qrafty-ai/hardware_designs/README.md

# hardware_designs

Hardware designs open-sourced by [QraftyAI](https://qrafty-ai.com).
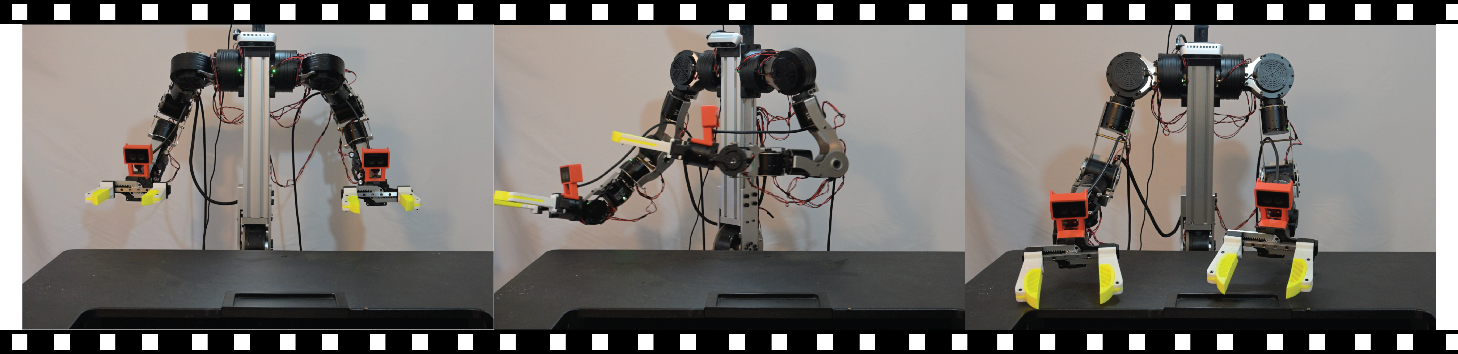
[picture p1: assets/fullarm.png]
Full Robot with Waist
  

Components:
+ `openarm_waist`: a waist extension for [OpenArm](https://openarm.dev/)
  
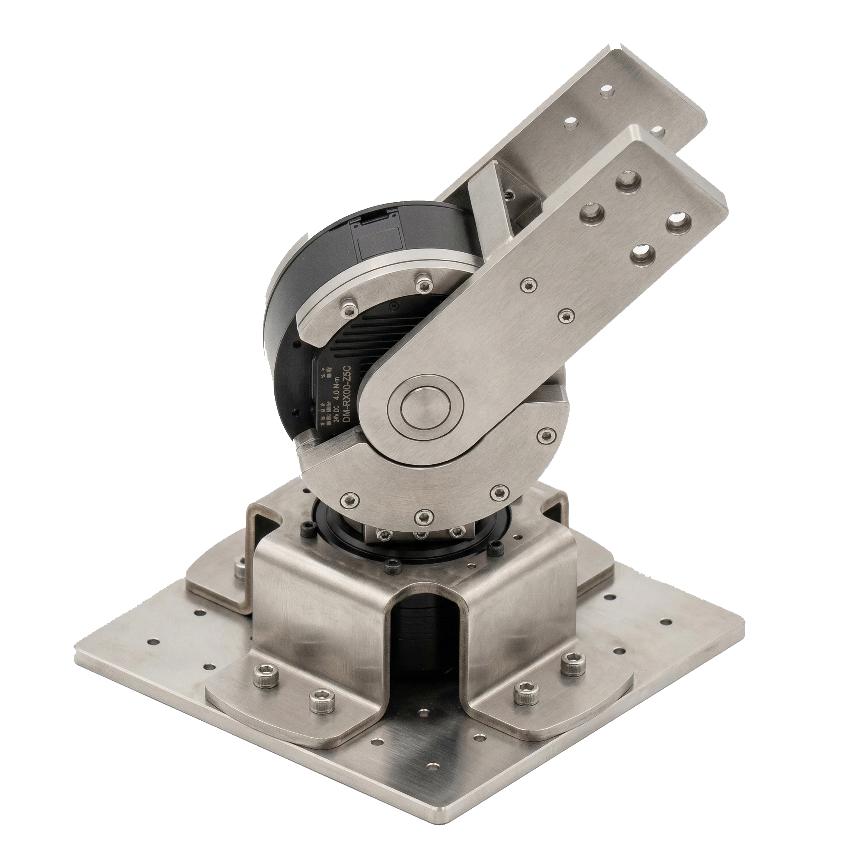
[picture p2: assets/waist_new.png]
Waist Assembly
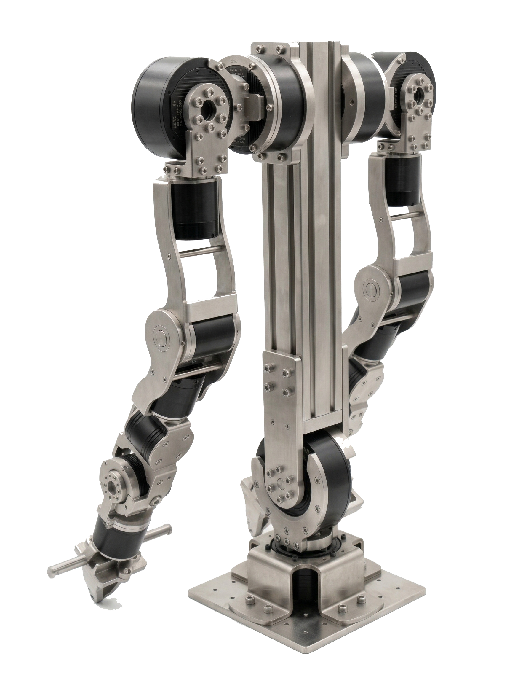
[picture p3: assets/fullrobot.png]
Full Robot with Waist
|  |  |
|:---:|:---:|
| Waist Assembly | Full Robot with Waist |
+ `teaarm_description`: full xacro/urdf description file for openarm with the custom waist
