qrafty-ai/hardware_designs/(list of files, cad)

Other CAD files:
openarm_waist/steps/assemble_urdf - J_waist_yaw_C.step
openarm_waist/steps/assemble_urdf - J_waist_pitch_C_CNC.step
openarm_waist/steps/assemble_urdf - J_waist_pitch_AB_CNC.step
openarm_waist/steps/assemble_urdf - J_waist_yaw_B_3D.step
openarm_waist/steps/assemble_urdf - J_waist_yaw_A_CNC.step
openarm_waist/steps/assemble_urdf - fl6804ZZ.step
openarm_waist/steps/assemble_urdf - square_base_plate.step
openarm_waist/steps/assemble_urdf - J_waist_yaw_A_CNC_A.step
openarm_waist/steps/assemble_urdf - J_waist_pitch_D_for_CNC.step
openarm_waist/steps/assemble_urdf - J_waist_yaw_A_CNC_B.step
openarm_waist/steps/assemble_urdf - base_sheet_metal.step
teaarm_description/meshes/collision/right_arm_l6_3.stl
teaarm_description/meshes/visual/torso_link.stl
teaarm_description/meshes/collision/right_arm_l4_7.stl
teaarm_description/meshes/visual/left_arm_l3.stl
teaarm_description/meshes/collision/right_arm_l1_4.stl
teaarm_description/meshes/visual/left_arm_l2.stl
teaarm_description/meshes/collision/waist_link_2.stl
teaarm_description/meshes/visual/right_arm_l6.stl
teaarm_description/meshes/collision/left_arm_l1_7.stl
teaarm_description/meshes/visual/right_arm_l1.stl
teaarm_description/meshes/collision/left_arm_l7_1.stl
teaarm_description/meshes/visual/right_arm_l7.stl
teaarm_description/meshes/collision/left_arm_l6_7.stl
teaarm_description/meshes/visual/right_arm_l2.stl
teaarm_description/meshes/collision/left_arm_l3_6.stl
teaarm_description/meshes/visual/right_arm_l5.stl
teaarm_description/meshes/collision/left_arm_l1_1.stl
teaarm_description/meshes/visual/left_arm_l5.stl
openarm_waist/steps/openarm_waist.step
teaarm_description/meshes/collision/right_arm_l1_6.stl
teaarm_description/meshes/visual/left_arm_l6.stl
teaarm_description/meshes/collision/right_arm_l5_7.stl
teaarm_description/meshes/visual/left_arm_l1.stl
teaarm_description/meshes/collision/right_arm_l6_5.stl
teaarm_description/meshes/visual/left_arm_l4.stl
teaarm_description/meshes/collision/left_arm_l3_3.stl
teaarm_description/meshes/visual/left_arm_l7.stl
teaarm_description/meshes/collision/left_arm_l6_6.stl
teaarm_description/meshes/visual/waist_link.stl
teaarm_description/meshes/collision/right_arm_l2_5.stl
teaarm_description/meshes/visual/base_link.stl
teaarm_description/meshes/collision/left_arm_l7_3.stl
teaarm_description/meshes/visual/right_arm_l3.stl
teaarm_description/meshes/collision/right_arm_l2_6.stl
teaarm_description/meshes/visual/right_arm_l4.stl
teaarm_description/meshes/collision/right_arm_l2_7.stl
teaarm_description/meshes/collision/base_link_4.stl
teaarm_description/meshes/collision/right_arm_l5_5.stl
teaarm_description/meshes/collision/left_arm_l4_7.stl
teaarm_description/meshes/collision/right_arm_l3_5.stl
teaarm_description/meshes/collision/right_arm_l2_4.stl
teaarm_description/meshes/collision/left_arm_l2_6.stl
teaarm_description/meshes/collision/right_arm_l1_3.stl
teaarm_description/meshes/collision/right_arm_l7_6.stl
teaarm_description/meshes/collision/left_arm_l3_1.stl
teaarm_description/meshes/collision/left_arm_l4_3.stl
teaarm_description/meshes/collision/left_arm_l3_4.stl
teaarm_description/meshes/collision/left_arm_l1_2.stl
teaarm_description/meshes/collision/right_arm_l1_0.stl
teaarm_description/meshes/collision/base_link_0.stl
teaarm_description/meshes/collision/waist_link_1.stl
teaarm_description/meshes/collision/right_arm_l5_0.stl
teaarm_description/meshes/collision/left_arm_l6_5.stl
teaarm_description/meshes/collision/left_arm_l5_2.stl
teaarm_description/meshes/collision/right_arm_l4_3.stl
teaarm_description/meshes/collision/right_arm_l3_3.stl
teaarm_description/meshes/collision/right_arm_l7_0.stl
teaarm_description/meshes/collision/right_arm_l2_2.stl
teaarm_description/meshes/collision/right_arm_l3_7.stl
teaarm_description/meshes/collision/left_arm_l6_2.stl
teaarm_description/meshes/collision/left_arm_l2_2.stl
teaarm_description/meshes/collision/left_arm_l7_2.stl
teaarm_description/meshes/collision/left_arm_l7_6.stl
teaarm_description/meshes/collision/left_arm_l4_4.stl
teaarm_description/meshes/collision/left_arm_l5_6.stl
teaarm_description/meshes/collision/right_arm_l7_2.stl
teaarm_description/meshes/collision/right_arm_l6_6.stl
teaarm_description/meshes/collision/left_arm_l4_0.stl
teaarm_description/meshes/collision/left_arm_l3_7.stl
teaarm_description/meshes/collision/right_arm_l1_2.stl
teaarm_description/meshes/collision/waist_link_6.stl
teaarm_description/meshes/collision/right_arm_l3_2.stl
teaarm_description/meshes/collision/left_arm_l5_7.stl
teaarm_description/meshes/collision/right_arm_l4_4.stl
teaarm_description/meshes/collision/right_arm_l4_0.stl
teaarm_description/meshes/collision/right_arm_l3_1.stl
teaarm_description/meshes/collision/left_arm_l4_6.stl
teaarm_description/meshes/collision/torso_link_3.stl
teaarm_description/meshes/collision/right_arm_l6_0.stl
teaarm_description/meshes/collision/left_arm_l3_5.stl
teaarm_description/meshes/collision/left_arm_l1_3.stl
teaarm_description/meshes/collision/left_arm_l3_2.stl
teaarm_description/meshes/collision/left_arm_l5_0.stl
teaarm_description/meshes/collision/right_arm_l6_7.stl
teaarm_description/meshes/collision/left_arm_l2_0.stl
teaarm_description/meshes/collision/left_arm_l6_1.stl
teaarm_description/meshes/collision/torso_link_4.stl
teaarm_description/meshes/collision/right_arm_l4_1.stl
teaarm_description/meshes/collision/base_link_6.stl
teaarm_description/meshes/collision/base_link_5.stl
teaarm_description/meshes/collision/right_arm_l3_4.stl
teaarm_description/meshes/collision/right_arm_l2_0.stl
teaarm_description/meshes/collision/right_arm_l2_1.stl
teaarm_description/meshes/collision/left_arm_l4_2.stl
teaarm_description/meshes/collision/right_arm_l7_3.stl
teaarm_description/meshes/collision/left_arm_l4_5.stl
teaarm_description/meshes/collision/left_arm_l2_5.stl
teaarm_description/meshes/collision/right_arm_l6_2.stl
teaarm_description/meshes/collision/right_arm_l7_7.stl
teaarm_description/meshes/collision/right_arm_l5_3.stl
teaarm_description/meshes/collision/left_arm_l7_7.stl
teaarm_description/meshes/collision/left_arm_l1_0.stl
teaarm_description/meshes/collision/right_arm_l6_4.stl
teaarm_description/meshes/collision/right_arm_l1_1.stl
teaarm_description/meshes/collision/waist_link_4.stl
teaarm_description/meshes/collision/left_arm_l2_3.stl
teaarm_description/meshes/collision/left_arm_l5_1.stl
teaarm_description/meshes/collision/right_arm_l4_5.stl
teaarm_description/meshes/collision/left_arm_l4_1.stl
teaarm_description/meshes/collision/right_arm_l7_4.stl
teaarm_description/meshes/collision/left_arm_l2_4.stl
teaarm_description/meshes/collision/left_arm_l2_1.stl
teaarm_description/meshes/collision/left_arm_l2_7.stl
teaarm_description/meshes/collision/left_arm_l3_0.stl
teaarm_description/meshes/collision/left_arm_l1_4.stl
teaarm_description/meshes/collision/right_arm_l5_4.stl
teaarm_description/meshes/collision/right_arm_l6_1.stl
teaarm_description/meshes/collision/waist_link_3.stl
teaarm_description/meshes/collision/left_arm_l7_0.stl
teaarm_description/meshes/collision/left_arm_l5_4.stl
teaarm_description/meshes/collision/left_arm_l7_5.stl
teaarm_description/meshes/collision/left_arm_l6_4.stl
teaarm_description/meshes/collision/right_arm_l1_7.stl
teaarm_description/meshes/collision/left_arm_l5_3.stl
teaarm_description/meshes/collision/right_arm_l4_2.stl
teaarm_description/meshes/collision/torso_link_5.stl
teaarm_description/meshes/collision/right_arm_l3_0.stl
teaarm_description/meshes/collision/left_arm_l6_0.stl
teaarm_description/meshes/collision/base_link_7.stl
teaarm_description/meshes/collision/waist_link_0.stl
teaarm_description/meshes/collision/right_arm_l7_1.stl
teaarm_description/meshes/collision/right_arm_l7_5.stl
teaarm_description/meshes/collision/right_arm_l4_6.stl
teaarm_description/meshes/collision/base_link_2.stl
teaarm_description/meshes/collision/right_arm_l1_5.stl
teaarm_description/meshes/collision/left_arm_l1_6.stl
teaarm_description/meshes/collision/left_arm_l7_4.stl
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
