qrafty-ai/hardware_designs/teaarm_description/inertia_debug.md

# Inertia and Mesh Calculation Debug Report

**Total Robot Weight:** 17.1417 kg

## Link: base_link

| Part | BOM Match | Mass Source | Material | Volume (cm³) | Mass (kg) | Mesh Match | Status |
|---|---|---|---|---|---|---|---|
| assemble_urdf_1_sub-asm-base_1_square_base_plate | (fuzzy: square_base_plate) | BOM Mass | Aluminum - 6061 | 313.38 | 0.8524 | FOUND | ⚠️ Fuzzy matched to BOM entry 'square_base_plate' |
| assemble_urdf_1_sub-asm-base_1_base_sheet_metal | (fuzzy: base_sheet_metal) | BOM Mass | Stainless Steel 304 | 149.89 | 1.2036 | FOUND | ⚠️ Fuzzy matched to BOM entry 'base_sheet_metal' |
| assemble_urdf_1_sub-asm-base_1_Hex_socket_head_cap_screw_M6x100_x_12 | (fuzzy: Hex socket head cap screw M6x1.00 x 12) | BOM Mass | Stainless Steel | 0.74 | 0.0057 | FOUND | ⚠️ Fuzzy matched to BOM entry 'Hex socket head cap screw M6x1.00 x 12' |
| assemble_urdf_1_sub-asm-base_1_Hex_socket_head_cap_screw_M6x100_x_12 | (fuzzy: Hex socket head cap screw M6x1.00 x 12) | BOM Mass | Stainless Steel | 0.74 | 0.0057 | FOUND | ⚠️ Fuzzy matched to BOM entry 'Hex socket head cap screw M6x1.00 x 12' |
| assemble_urdf_1_sub-asm-base_1_Hex_socket_head_cap_screw_M6x100_x_12 | (fuzzy: Hex socket head cap screw M6x1.00 x 12) | BOM Mass | Stainless Steel | 0.74 | 0.0057 | FOUND | ⚠️ Fuzzy matched to BOM entry 'Hex socket head cap screw M6x1.00 x 12' |
| assemble_urdf_1_sub-asm-base_1_Hex_socket_head_cap_screw_M6x100_x_12 | (fuzzy: Hex socket head cap screw M6x1.00 x 12) | BOM Mass | Stainless Steel | 0.74 | 0.0057 | FOUND | ⚠️ Fuzzy matched to BOM entry 'Hex socket head cap screw M6x1.00 x 12' |
| assemble_urdf_1_sub-asm-base_1_Hex_socket_head_cap_screw_M6x100_x_12 | (fuzzy: Hex socket head cap screw M6x1.00 x 12) | BOM Mass | Stainless Steel | 0.74 | 0.0057 | FOUND | ⚠️ Fuzzy matched to BOM entry 'Hex socket head cap screw M6x1.00 x 12' |
| assemble_urdf_1_sub-asm-base_1_Hex_socket_head_cap_screw_M6x100_x_12 | (fuzzy: Hex socket head cap screw M6x1.00 x 12) | BOM Mass | Stainless Steel | 0.74 | 0.0057 | FOUND | ⚠️ Fuzzy matched to BOM entry 'Hex socket head cap screw M6x1.00 x 12' |
| assemble_urdf_1_sub-asm-base_1_Hex_socket_head_cap_screw_M6x100_x_12 | (fuzzy: Hex socket head cap screw M6x1.00 x 12) | BOM Mass | Stainless Steel | 0.74 | 0.0057 | FOUND | ⚠️ Fuzzy matched to BOM entry 'Hex socket head cap screw M6x1.00 x 12' |
| assemble_urdf_1_sub-asm-base_1_Hex_socket_head_cap_screw_M6x100_x_12 | (fuzzy: Hex socket head cap screw M6x1.00 x 12) | BOM Mass | Stainless Steel | 0.74 | 0.0057 | FOUND | ⚠️ Fuzzy matched to BOM entry 'Hex socket head cap screw M6x1.00 x 12' |
| assemble_urdf_1_sub-asm-base_1_8009P | (fuzzy: 8009P) | BOM Mass | - | 387.45 | 0.9210 | FOUND | ⚠️ Fuzzy matched to BOM entry '8009P' |
| assemble_urdf_1_sub-asm-base_1_Hex_socket_head_cap_screw_M4x070_x_10 | (fuzzy: Hex socket head cap screw M4x0.70 x 10) | BOM Mass | Stainless Steel | 0.26 | 0.0020 | FOUND | ⚠️ Fuzzy matched to BOM entry 'Hex socket head cap screw M4x0.70 x 10' |
| assemble_urdf_1_sub-asm-base_1_Hex_socket_head_cap_screw_M4x070_x_10 | (fuzzy: Hex socket head cap screw M4x0.70 x 10) | BOM Mass | Stainless Steel | 0.26 | 0.0020 | FOUND | ⚠️ Fuzzy matched to BOM entry 'Hex socket head cap screw M4x0.70 x 10' |
| assemble_urdf_1_sub-asm-base_1_Hex_socket_head_cap_screw_M4x070_x_10 | (fuzzy: Hex socket head cap screw M4x0.70 x 10) | BOM Mass | Stainless Steel | 0.26 | 0.0020 | FOUND | ⚠️ Fuzzy matched to BOM entry 'Hex socket head cap screw M4x0.70 x 10' |
| assemble_urdf_1_sub-asm-base_1_Hex_socket_head_cap_screw_M4x070_x_10 | (fuzzy: Hex socket head cap screw M4x0.70 x 10) | BOM Mass | Stainless Steel | 0.26 | 0.0020 | FOUND | ⚠️ Fuzzy matched to BOM entry 'Hex socket head cap screw M4x0.70 x 10' |
| assemble_urdf_1_sub-asm-base_1_Hex_socket_head_cap_screw_M4x070_x_10 | (fuzzy: Hex socket head cap screw M4x0.70 x 10) | BOM Mass | Stainless Steel | 0.26 | 0.0020 | FOUND | ⚠️ Fuzzy matched to BOM entry 'Hex socket head cap screw M4x0.70 x 10' |
| assemble_urdf_1_sub-asm-base_1_Hex_socket_head_cap_screw_M4x070_x_10 | (fuzzy: Hex socket head cap screw M4x0.70 x 10) | BOM Mass | Stainless Steel | 0.26 | 0.0020 | FOUND | ⚠️ Fuzzy matched to BOM entry 'Hex socket head cap screw M4x0.70 x 10' |

**Link Total:** 3.0349 kg
**Warnings:** 17 parts with issues

---

## Link: left_arm_l1

| Part | BOM Match | Mass Source | Material | Volume (cm³) | Mass (kg) | Mesh Match | Status |
|---|---|---|---|---|---|---|---|
| left_arm_1_l1_ASM_2_J1_C | (fuzzy: J1_C) | BOM Mass | Aluminum - 6061 | 23.08 | 0.0628 | FOUND | ⚠️ Fuzzy matched to BOM entry 'J1_C' |
| left_arm_1_l1_ASM_2_J1_D | (fuzzy: J1_D) | BOM Mass | Stainless Steel 304 | 3.51 | 0.0282 | FOUND | ⚠️ Fuzzy matched to BOM entry 'J1_D' |
| left_arm_1_l1_ASM_2_J1_E | (fuzzy: J1_E) | BOM Mass | Stainless Steel 304 | 3.86 | 0.0310 | FOUND | ⚠️ Fuzzy matched to BOM entry 'J1_E' |
| left_arm_1_l1_ASM_2_Hex_socket_head_cap_screw_M5x080_x_10 | (fuzzy: Hex socket head cap screw M5x0.80 x 10) | BOM Mass | Stainless Steel | 0.44 | 0.0034 | FOUND | ⚠️ Fuzzy matched to BOM entry 'Hex socket head cap screw M5x0.80 x 10' |
| left_arm_1_l1_ASM_2_Hex_socket_head_cap_screw_M5x080_x_10 | (fuzzy: Hex socket head cap screw M5x0.80 x 10) | BOM Mass | Stainless Steel | 0.44 | 0.0034 | FOUND | ⚠️ Fuzzy matched to BOM entry 'Hex socket head cap screw M5x0.80 x 10' |
| left_arm_1_l1_ASM_2_Hex_socket_head_cap_screw_M5x080_x_10 | (fuzzy: Hex socket head cap screw M5x0.80 x 10) | BOM Mass | Stainless Steel | 0.44 | 0.0034 | FOUND | ⚠️ Fuzzy matched to BOM entry 'Hex socket head cap screw M5x0.80 x 10' |
| left_arm_1_l1_ASM_2_Hex_socket_head_cap_screw_M5x080_x_10 | (fuzzy: Hex socket head cap screw M5x0.80 x 10) | BOM Mass | Stainless Steel | 0.44 | 0.0034 | FOUND | ⚠️ Fuzzy matched to BOM entry 'Hex socket head cap screw M5x0.80 x 10' |
| left_arm_1_l1_ASM_2_Hex_socket_head_cap_screw_M5x080_x_10 | (fuzzy: Hex socket head cap screw M5x0.80 x 10) | BOM Mass | Stainless Steel | 0.44 | 0.0034 | FOUND | ⚠️ Fuzzy matched to BOM entry 'Hex socket head cap screw M5x0.80 x 10' |
| left_arm_1_l1_ASM_2_Hex_socket_head_cap_screw_M4x070_x_10 | (fuzzy: Hex socket head cap screw M4x0.70 x 10) | BOM Mass | Stainless Steel | 0.26 | 0.0020 | FOUND | ⚠️ Fuzzy matched to BOM entry 'Hex socket head cap screw M4x0.70 x 10' |
| left_arm_1_l1_ASM_2_Hex_socket_head_cap_screw_M4x070_x_10 | (fuzzy: Hex socket head cap screw M4x0.70 x 10) | BOM Mass | Stainless Steel | 0.26 | 0.0020 | FOUND | ⚠️ Fuzzy matched to BOM entry 'Hex socket head cap screw M4x0.70 x 10' |
| left_arm_1_l1_ASM_2_Hex_socket_head_cap_screw_M4x070_x_8 | (fuzzy: Hex socket head cap screw M4x0.70 x 8) | BOM Mass | Stainless Steel | 0.24 | 0.0018 | FOUND | ⚠️ Fuzzy matched to BOM entry 'Hex socket head cap screw M4x0.70 x 8' |
| left_arm_1_l1_ASM_2_Hex_socket_head_cap_screw_M4x070_x_8 | (fuzzy: Hex socket head cap screw M4x0.70 x 8) | BOM Mass | Stainless Steel | 0.24 | 0.0018 | FOUND | ⚠️ Fuzzy matched to BOM entry 'Hex socket head cap screw M4x0.70 x 8' |
| left_arm_1_l1_ASM_2_Hex_socket_head_cap_screw_M4x070_x_8 | (fuzzy: Hex socket head cap screw M4x0.70 x 8) | BOM Mass | Stainless Steel | 0.24 | 0.0018 | FOUND | ⚠️ Fuzzy matched to BOM entry 'Hex socket head cap screw M4x0.70 x 8' |
| left_arm_1_l1_ASM_2_DM-J8009P-2EC | (fuzzy: DM-J8009P-2EC) | BOM Mass | - | 387.45 | 0.9210 | FOUND | ⚠️ Fuzzy matched to BOM entry 'DM-J8009P-2EC' |
| left_arm_1_l1_ASM_2_Hex_socket_head_cap_screw_M4x070_x_10 | (fuzzy: Hex socket head cap screw M4x0.70 x 10) | BOM Mass | Stainless Steel | 0.26 | 0.0020 | FOUND | ⚠️ Fuzzy matched to BOM entry 'Hex socket head cap screw M4x0.70 x 10' |
| left_arm_1_l1_ASM_2_Hex_socket_head_cap_screw_M4x070_x_10 | (fuzzy: Hex socket head cap screw M4x0.70 x 10) | BOM Mass | Stainless Steel | 0.26 | 0.0020 | FOUND | ⚠️ Fuzzy matched to BOM entry 'Hex socket head cap screw M4x0.70 x 10' |
| left_arm_1_l1_ASM_2_Hex_socket_head_cap_screw_M4x070_x_10 | (fuzzy: Hex socket head cap screw M4x0.70 x 10) | BOM Mass | Stainless Steel | 0.26 | 0.0020 | FOUND | ⚠️ Fuzzy matched to BOM entry 'Hex socket head cap screw M4x0.70 x 10' |
| left_arm_1_l1_ASM_2_Hex_socket_head_cap_screw_M4x070_x_8 | (fuzzy: Hex socket head cap screw M4x0.70 x 8) | BOM Mass | Stainless Steel | 0.24 | 0.0018 | FOUND | ⚠️ Fuzzy matched to BOM entry 'Hex socket head cap screw M4x0.70 x 8' |

**Link Total:** 1.0775 kg
**Warnings:** 18 parts with issues

---

## Link: left_arm_l2

| Part | BOM Match | Mass Source | Material | Volume (cm³) | Mass (kg) | Mesh Match | Status |
|---|---|---|---|---|---|---|---|
| left_arm_1_l2_ASM_2_J2_A | (fuzzy: J2_A) | BOM Mass | Stainless Steel 304 | 14.18 | 0.1138 | FOUND | ⚠️ Fuzzy matched to BOM entry 'J2_A' |
| left_arm_1_l2_ASM_2_J2_C | (fuzzy: J2_C) | BOM Mass | Stainless Steel 304 | 4.05 | 0.0325 | FOUND | ⚠️ Fuzzy matched to BOM entry 'J2_C' |
| left_arm_1_l2_ASM_2_Hex_socket_head_cap_screw_M4x070_x_10 | (fuzzy: Hex socket head cap screw M4x0.70 x 10) | BOM Mass | Stainless Steel | 0.26 | 0.0020 | FOUND | ⚠️ Fuzzy matched to BOM entry 'Hex socket head cap screw M4x0.70 x 10' |
| left_arm_1_l2_ASM_2_Hex_socket_head_cap_screw_M5x080_x_10 | (fuzzy: Hex socket head cap screw M5x0.80 x 10) | BOM Mass | Stainless Steel | 0.44 | 0.0034 | FOUND | ⚠️ Fuzzy matched to BOM entry 'Hex socket head cap screw M5x0.80 x 10' |
| left_arm_1_l2_ASM_2_Hex_socket_head_cap_screw_M5x080_x_10 | (fuzzy: Hex socket head cap screw M5x0.80 x 10) | BOM Mass | Stainless Steel | 0.44 | 0.0034 | FOUND | ⚠️ Fuzzy matched to BOM entry 'Hex socket head cap screw M5x0.80 x 10' |
| left_arm_1_l2_ASM_2_Hex_socket_head_cap_screw_M5x080_x_10 | (fuzzy: Hex socket head cap screw M5x0.80 x 10) | BOM Mass | Stainless Steel | 0.44 | 0.0034 | FOUND | ⚠️ Fuzzy matched to BOM entry 'Hex socket head cap screw M5x0.80 x 10' |
| left_arm_1_l2_ASM_2_Hex_socket_head_cap_screw_M5x080_x_10 | (fuzzy: Hex socket head cap screw M5x0.80 x 10) | BOM Mass | Stainless Steel | 0.44 | 0.0034 | FOUND | ⚠️ Fuzzy matched to BOM entry 'Hex socket head cap screw M5x0.80 x 10' |
| left_arm_1_l2_ASM_2_Hex_socket_head_cap_screw_M5x080_x_10 | (fuzzy: Hex socket head cap screw M5x0.80 x 10) | BOM Mass | Stainless Steel | 0.44 | 0.0034 | FOUND | ⚠️ Fuzzy matched to BOM entry 'Hex socket head cap screw M5x0.80 x 10' |
| left_arm_1_l2_ASM_2_Hex_socket_head_cap_screw_M5x080_x_10 | (fuzzy: Hex socket head cap screw M5x0.80 x 10) | BOM Mass | Stainless Steel | 0.44 | 0.0034 | FOUND | ⚠️ Fuzzy matched to BOM entry 'Hex socket head cap screw M5x0.80 x 10' |
| left_arm_1_l2_ASM_2_Hex_socket_head_cap_screw_M3x050_x_8 | (fuzzy: Hex socket head cap screw M3x0.50 x 8) | BOM Mass | Stainless Steel | 0.12 | 0.0009 | FOUND | ⚠️ Fuzzy matched to BOM entry 'Hex socket head cap screw M3x0.50 x 8' |
| left_arm_1_l2_ASM_2_J2_B | (fuzzy: J2_B) | BOM Mass | Aluminum - 6061 | 22.81 | 0.0620 | FOUND | ⚠️ Fuzzy matched to BOM entry 'J2_B' |
| left_arm_1_l2_ASM_2_Hex_socket_head_cap_screw_M4x070_x_6 | (fuzzy: Hex socket head cap screw M4x0.70 x 6) | BOM Mass | Stainless Steel | 0.21 | 0.0016 | FOUND | ⚠️ Fuzzy matched to BOM entry 'Hex socket head cap screw M4x0.70 x 6' |
| left_arm_1_l2_ASM_2_Hex_socket_head_cap_screw_M4x070_x_6 | (fuzzy: Hex socket head cap screw M4x0.70 x 6) | BOM Mass | Stainless Steel | 0.21 | 0.0016 | FOUND | ⚠️ Fuzzy matched to BOM entry 'Hex socket head cap screw M4x0.70 x 6' |
| left_arm_1_l2_ASM_2_Hex_socket_head_cap_screw_M4x070_x_6 | (fuzzy: Hex socket head cap screw M4x0.70 x 6) | BOM Mass | Stainless Steel | 0.21 | 0.0016 | FOUND | ⚠️ Fuzzy matched to BOM entry 'Hex socket head cap screw M4x0.70 x 6' |
| left_arm_1_l2_ASM_2_Hex_socket_head_cap_screw_M4x070_x_6 | (fuzzy: Hex socket head cap screw M4x0.70 x 6) | BOM Mass | Stainless Steel | 0.21 | 0.0016 | FOUND | ⚠️ Fuzzy matched to BOM entry 'Hex socket head cap screw M4x0.70 x 6' |
| left_arm_1_l2_ASM_2_Hex_socket_head_cap_screw_M4x070_x_6 | (fuzzy: Hex socket head cap screw M4x0.70 x 6) | BOM Mass | Stainless Steel | 0.21 | 0.0016 | FOUND | ⚠️ Fuzzy matched to BOM entry 'Hex socket head cap screw M4x0.70 x 6' |
| left_arm_1_l2_ASM_2_Hex_socket_head_cap_screw_M4x070_x_6 | (fuzzy: Hex socket head cap screw M4x0.70 x 6) | BOM Mass | Stainless Steel | 0.21 | 0.0016 | FOUND | ⚠️ Fuzzy matched to BOM entry 'Hex socket head cap screw M4x0.70 x 6' |
| left_arm_1_l2_ASM_2_Hex_socket_head_cap_screw_M4x070_x_6 | (fuzzy: Hex socket head cap screw M4x0.70 x 6) | BOM Mass | Stainless Steel | 0.21 | 0.0016 | FOUND | ⚠️ Fuzzy matched to BOM entry 'Hex socket head cap screw M4x0.70 x 6' |
| left_arm_1_l2_ASM_2_Hex_socket_head_cap_screw_M4x070_x_6 | (fuzzy: Hex socket head cap screw M4x0.70 x 6) | BOM Mass | Stainless Steel | 0.21 | 0.0016 | FOUND | ⚠️ Fuzzy matched to BOM entry 'Hex socket head cap screw M4x0.70 x 6' |
| left_arm_1_l2_ASM_2_Hex_socket_head_cap_screw_M3x050_x_14 | (fuzzy: Hex socket head cap screw M3x0.50 x 14) | BOM Mass | Stainless Steel | 0.16 | 0.0013 | FOUND | ⚠️ Fuzzy matched to BOM entry 'Hex socket head cap screw M3x0.50 x 14' |
| left_arm_1_l2_ASM_2_Hex_socket_head_cap_screw_M3x050_x_14 | (fuzzy: Hex socket head cap screw M3x0.50 x 14) | BOM Mass | Stainless Steel | 0.16 | 0.0013 | FOUND | ⚠️ Fuzzy matched to BOM entry 'Hex socket head cap screw M3x0.50 x 14' |
| left_arm_1_l2_ASM_2_Hex_socket_head_cap_screw_M3x050_x_14 | (fuzzy: Hex socket head cap screw M3x0.50 x 14) | BOM Mass | Stainless Steel | 0.16 | 0.0013 | FOUND | ⚠️ Fuzzy matched to BOM entry 'Hex socket head cap screw M3x0.50 x 14' |
| left_arm_1_l2_ASM_2_Hex_socket_head_cap_screw_M3x050_x_14 | (fuzzy: Hex socket head cap screw M3x0.50 x 14) | BOM Mass | Stainless Steel | 0.16 | 0.0013 | FOUND | ⚠️ Fuzzy matched to BOM entry 'Hex socket head cap screw M3x0.50 x 14' |
| left_arm_1_l2_ASM_2_Hex_socket_head_cap_screw_M3x050_x_14 | (fuzzy: Hex socket head cap screw M3x0.50 x 14) | BOM Mass | Stainless Steel | 0.16 | 0.0013 | FOUND | ⚠️ Fuzzy matched to BOM entry 'Hex socket head cap screw M3x0.50 x 14' |
| left_arm_1_l2_ASM_2_Hex_socket_head_cap_screw_M3x050_x_14 | (fuzzy: Hex socket head cap screw M3x0.50 x 14) | BOM Mass | Stainless Steel | 0.16 | 0.0013 | FOUND | ⚠️ Fuzzy matched to BOM entry 'Hex socket head cap screw M3x0.50 x 14' |

**Link Total:** 0.2526 kg
**Warnings:** 25 parts with issues

---

## Link: left_arm_l3

| Part | BOM Match | Mass Source | Material | Volume (cm³) | Mass (kg) | Mesh Match | Status |
|---|---|---|---|---|---|---|---|
| left_arm_1_l3_ASM_2_4340P | (fuzzy: 4340P) | BOM Mass | - | 135.71 | 0.3750 | FOUND | ⚠️ Fuzzy matched to BOM entry '4340P' |
| left_arm_1_l3_ASM_2_J4_A | (fuzzy: J4_A) | BOM Mass | Stainless Steel 304 | 23.37 | 0.1877 | FOUND | ⚠️ Fuzzy matched to BOM entry 'J4_A' |
| left_arm_1_l3_ASM_2_4340 | (fuzzy: 4340) | BOM Mass | - | 128.48 | 0.3620 | FOUND | ⚠️ Fuzzy matched to BOM entry '4340' |
| left_arm_1_l3_ASM_2_Hex_socket_head_cap_screw_M3x050_x_6 | (fuzzy: Hex socket head cap screw M3x0.50 x 6) | BOM Mass | Stainless Steel | 0.11 | 0.0008 | FOUND | ⚠️ Fuzzy matched to BOM entry 'Hex socket head cap screw M3x0.50 x 6' |
| left_arm_1_l3_ASM_2_Hex_socket_head_cap_screw_M3x050_x_6 | (fuzzy: Hex socket head cap screw M3x0.50 x 6) | BOM Mass | Stainless Steel | 0.11 | 0.0008 | FOUND | ⚠️ Fuzzy matched to BOM entry 'Hex socket head cap screw M3x0.50 x 6' |
| left_arm_1_l3_ASM_2_Hex_socket_head_cap_screw_M3x050_x_6 | (fuzzy: Hex socket head cap screw M3x0.50 x 6) | BOM Mass | Stainless Steel | 0.11 | 0.0008 | FOUND | ⚠️ Fuzzy matched to BOM entry 'Hex socket head cap screw M3x0.50 x 6' |
| left_arm_1_l3_ASM_2_Hex_socket_head_cap_screw_M3x050_x_6 | (fuzzy: Hex socket head cap screw M3x0.50 x 6) | BOM Mass | Stainless Steel | 0.11 | 0.0008 | FOUND | ⚠️ Fuzzy matched to BOM entry 'Hex socket head cap screw M3x0.50 x 6' |
| left_arm_1_l3_ASM_2_Hex_socket_head_cap_screw_M3x050_x_6 | (fuzzy: Hex socket head cap screw M3x0.50 x 6) | BOM Mass | Stainless Steel | 0.11 | 0.0008 | FOUND | ⚠️ Fuzzy matched to BOM entry 'Hex socket head cap screw M3x0.50 x 6' |
| left_arm_1_l3_ASM_2_Hex_socket_head_cap_screw_M3x050_x_6 | (fuzzy: Hex socket head cap screw M3x0.50 x 6) | BOM Mass | Stainless Steel | 0.11 | 0.0008 | FOUND | ⚠️ Fuzzy matched to BOM entry 'Hex socket head cap screw M3x0.50 x 6' |
| left_arm_1_l3_ASM_2_Hex_socket_head_cap_screw_M3x050_x_6 | (fuzzy: Hex socket head cap screw M3x0.50 x 6) | BOM Mass | Stainless Steel | 0.11 | 0.0008 | FOUND | ⚠️ Fuzzy matched to BOM entry 'Hex socket head cap screw M3x0.50 x 6' |
| left_arm_1_l3_ASM_2_Hex_socket_head_cap_screw_M3x050_x_6 | (fuzzy: Hex socket head cap screw M3x0.50 x 6) | BOM Mass | Stainless Steel | 0.11 | 0.0008 | FOUND | ⚠️ Fuzzy matched to BOM entry 'Hex socket head cap screw M3x0.50 x 6' |
| left_arm_1_l3_ASM_2_Hex_socket_head_cap_screw_M3x050_x_6 | (fuzzy: Hex socket head cap screw M3x0.50 x 6) | BOM Mass | Stainless Steel | 0.11 | 0.0008 | FOUND | ⚠️ Fuzzy matched to BOM entry 'Hex socket head cap screw M3x0.50 x 6' |
| left_arm_1_l3_ASM_2_Hex_socket_head_cap_screw_M3x050_x_6 | (fuzzy: Hex socket head cap screw M3x0.50 x 6) | BOM Mass | Stainless Steel | 0.11 | 0.0008 | FOUND | ⚠️ Fuzzy matched to BOM entry 'Hex socket head cap screw M3x0.50 x 6' |
| left_arm_1_l3_ASM_2_Hex_socket_head_cap_screw_M3x050_x_6 | (fuzzy: Hex socket head cap screw M3x0.50 x 6) | BOM Mass | Stainless Steel | 0.11 | 0.0008 | FOUND | ⚠️ Fuzzy matched to BOM entry 'Hex socket head cap screw M3x0.50 x 6' |
| left_arm_1_l3_ASM_2_Hex_socket_head_cap_screw_M3x050_x_6 | (fuzzy: Hex socket head cap screw M3x0.50 x 6) | BOM Mass | Stainless Steel | 0.11 | 0.0008 | FOUND | ⚠️ Fuzzy matched to BOM entry 'Hex socket head cap screw M3x0.50 x 6' |
| left_arm_1_l3_ASM_2_Hex_socket_head_cap_screw_M3x050_x_6 | (fuzzy: Hex socket head cap screw M3x0.50 x 6) | BOM Mass | Stainless Steel | 0.11 | 0.0008 | FOUND | ⚠️ Fuzzy matched to BOM entry 'Hex socket head cap screw M3x0.50 x 6' |
| left_arm_1_l3_ASM_2_Hex_socket_head_cap_screw_M3x050_x_6 | (fuzzy: Hex socket head cap screw M3x0.50 x 6) | BOM Mass | Stainless Steel | 0.11 | 0.0008 | FOUND | ⚠️ Fuzzy matched to BOM entry 'Hex socket head cap screw M3x0.50 x 6' |
| left_arm_1_l3_ASM_2_Hex_socket_head_cap_screw_M3x050_x_6 | (fuzzy: Hex socket head cap screw M3x0.50 x 6) | BOM Mass | Stainless Steel | 0.11 | 0.0008 | FOUND | ⚠️ Fuzzy matched to BOM entry 'Hex socket head cap screw M3x0.50 x 6' |
| left_arm_1_l3_ASM_2_Hex_socket_head_cap_screw_M3x050_x_6 | (fuzzy: Hex socket head cap screw M3x0.50 x 6) | BOM Mass | Stainless Steel | 0.11 | 0.0008 | FOUND | ⚠️ Fuzzy matched to BOM entry 'Hex socket head cap screw M3x0.50 x 6' |
| left_arm_1_l3_ASM_2_Hex_socket_head_cap_screw_M3x050_x_6 | (fuzzy: Hex socket head cap screw M3x0.50 x 6) | BOM Mass | Stainless Steel | 0.11 | 0.0008 | FOUND | ⚠️ Fuzzy matched to BOM entry 'Hex socket head cap screw M3x0.50 x 6' |
| left_arm_1_l3_ASM_2_Hex_socket_head_cap_screw_M3x050_x_6 | (fuzzy: Hex socket head cap screw M3x0.50 x 6) | BOM Mass | Stainless Steel | 0.11 | 0.0008 | FOUND | ⚠️ Fuzzy matched to BOM entry 'Hex socket head cap screw M3x0.50 x 6' |
| left_arm_1_l3_ASM_2_copper_pillar_61 | (fuzzy: copper pillar 61) | BOM Mass | Copper | 1.30 | 0.0116 | FOUND | ⚠️ Fuzzy matched to BOM entry 'copper pillar 61' |
| left_arm_1_l3_ASM_2_Hex_socket_head_cap_screw_M3x050_x_8 | (fuzzy: Hex socket head cap screw M3x0.50 x 8) | BOM Mass | Stainless Steel | 0.12 | 0.0009 | FOUND | ⚠️ Fuzzy matched to BOM entry 'Hex socket head cap screw M3x0.50 x 8' |
| left_arm_1_l3_ASM_2_Hex_socket_head_cap_screw_M3x050_x_8 | (fuzzy: Hex socket head cap screw M3x0.50 x 8) | BOM Mass | Stainless Steel | 0.12 | 0.0009 | FOUND | ⚠️ Fuzzy matched to BOM entry 'Hex socket head cap screw M3x0.50 x 8' |
| left_arm_1_l3_ASM_2_J4_B | (fuzzy: J4_B) | BOM Mass | ppa-cf | 25.43 | 0.0318 | FOUND | ⚠️ Fuzzy matched to BOM entry 'J4_B' |
| left_arm_1_l3_ASM_2_C-FL6803ZZ | (fuzzy: C-FL6803ZZ) | BOM Mass | - | 1.54 | 0.0000 | FOUND | ⚠️ Fuzzy matched to BOM entry 'C-FL6803ZZ' |
| left_arm_1_l3_ASM_2_Hex_socket_head_cap_screw_M3x050_x_6 | (fuzzy: Hex socket head cap screw M3x0.50 x 6) | BOM Mass | Stainless Steel | 0.11 | 0.0008 | FOUND | ⚠️ Fuzzy matched to BOM entry 'Hex socket head cap screw M3x0.50 x 6' |
| left_arm_1_l3_ASM_2_Hex_socket_head_cap_screw_M3x050_x_6 | (fuzzy: Hex socket head cap screw M3x0.50 x 6) | BOM Mass | Stainless Steel | 0.11 | 0.0008 | FOUND | ⚠️ Fuzzy matched to BOM entry 'Hex socket head cap screw M3x0.50 x 6' |
| left_arm_1_l3_ASM_2_Hex_socket_head_cap_screw_M3x050_x_6 | (fuzzy: Hex socket head cap screw M3x0.50 x 6) | BOM Mass | Stainless Steel | 0.11 | 0.0008 | FOUND | ⚠️ Fuzzy matched to BOM entry 'Hex socket head cap screw M3x0.50 x 6' |
| left_arm_1_l3_ASM_2_Hex_socket_head_cap_screw_M3x050_x_6 | (fuzzy: Hex socket head cap screw M3x0.50 x 6) | BOM Mass | Stainless Steel | 0.11 | 0.0008 | FOUND | ⚠️ Fuzzy matched to BOM entry 'Hex socket head cap screw M3x0.50 x 6' |

**Link Total:** 0.9880 kg
**Warnings:** 30 parts with issues

---

## Link: left_arm_l4

| Part | BOM Match | Mass Source | Material | Volume (cm³) | Mass (kg) | Mesh Match | Status |
|---|---|---|---|---|---|---|---|
| left_arm_1_l4_ASM_2_J4_C | (fuzzy: J4_C) | BOM Mass | Aluminum - 6061 | 4.54 | 0.0123 | FOUND | ⚠️ Fuzzy matched to BOM entry 'J4_C' |
| left_arm_1_l4_ASM_2_J4_E | (fuzzy: J4_E) | BOM Mass | Stainless Steel 304 | 9.95 | 0.0799 | FOUND | ⚠️ Fuzzy matched to BOM entry 'J4_E' |
| left_arm_1_l4_ASM_2_Hex_socket_head_cap_screw_M3x050_x_6 | (fuzzy: Hex socket head cap screw M3x0.50 x 6) | BOM Mass | Stainless Steel | 0.11 | 0.0008 | FOUND | ⚠️ Fuzzy matched to BOM entry 'Hex socket head cap screw M3x0.50 x 6' |
| left_arm_1_l4_ASM_2_Hex_socket_head_cap_screw_M3x050_x_6 | (fuzzy: Hex socket head cap screw M3x0.50 x 6) | BOM Mass | Stainless Steel | 0.11 | 0.0008 | FOUND | ⚠️ Fuzzy matched to BOM entry 'Hex socket head cap screw M3x0.50 x 6' |
| left_arm_1_l4_ASM_2_Hex_socket_head_cap_screw_M3x050_x_6 | (fuzzy: Hex socket head cap screw M3x0.50 x 6) | BOM Mass | Stainless Steel | 0.11 | 0.0008 | FOUND | ⚠️ Fuzzy matched to BOM entry 'Hex socket head cap screw M3x0.50 x 6' |
| left_arm_1_l4_ASM_2_Hex_socket_head_cap_screw_M3x050_x_6 | (fuzzy: Hex socket head cap screw M3x0.50 x 6) | BOM Mass | Stainless Steel | 0.11 | 0.0008 | FOUND | ⚠️ Fuzzy matched to BOM entry 'Hex socket head cap screw M3x0.50 x 6' |
| left_arm_1_l4_ASM_2_Hex_socket_head_cap_screw_M3x050_x_6 | (fuzzy: Hex socket head cap screw M3x0.50 x 6) | BOM Mass | Stainless Steel | 0.11 | 0.0008 | FOUND | ⚠️ Fuzzy matched to BOM entry 'Hex socket head cap screw M3x0.50 x 6' |
| left_arm_1_l4_ASM_2_Hex_socket_head_cap_screw_M3x050_x_6 | (fuzzy: Hex socket head cap screw M3x0.50 x 6) | BOM Mass | Stainless Steel | 0.11 | 0.0008 | FOUND | ⚠️ Fuzzy matched to BOM entry 'Hex socket head cap screw M3x0.50 x 6' |
| left_arm_1_l4_ASM_2_4310 | (fuzzy: 4310) | BOM Mass | - | 109.88 | 0.3000 | FOUND | ⚠️ Fuzzy matched to BOM entry '4310' |
| left_arm_1_l4_ASM_2_copper_pillar_742 | (fuzzy: copper pillar 74.2) | BOM Mass | Copper | 1.58 | 0.0141 | FOUND | ⚠️ Fuzzy matched to BOM entry 'copper pillar 74.2' |
| left_arm_1_l4_ASM_2_copper_pillar_742 | (fuzzy: copper pillar 74.2) | BOM Mass | Copper | 1.58 | 0.0141 | FOUND | ⚠️ Fuzzy matched to BOM entry 'copper pillar 74.2' |
| left_arm_1_l4_ASM_2_Hex_socket_head_cap_screw_M3x050_x_8 | (fuzzy: Hex socket head cap screw M3x0.50 x 8) | BOM Mass | Stainless Steel | 0.12 | 0.0009 | FOUND | ⚠️ Fuzzy matched to BOM entry 'Hex socket head cap screw M3x0.50 x 8' |
| left_arm_1_l4_ASM_2_Hex_socket_head_cap_screw_M3x050_x_8 | (fuzzy: Hex socket head cap screw M3x0.50 x 8) | BOM Mass | Stainless Steel | 0.12 | 0.0009 | FOUND | ⚠️ Fuzzy matched to BOM entry 'Hex socket head cap screw M3x0.50 x 8' |
| left_arm_1_l4_ASM_2_Hex_socket_head_cap_screw_M3x050_x_6 | (fuzzy: Hex socket head cap screw M3x0.50 x 6) | BOM Mass | Stainless Steel | 0.11 | 0.0008 | FOUND | ⚠️ Fuzzy matched to BOM entry 'Hex socket head cap screw M3x0.50 x 6' |
| left_arm_1_l4_ASM_2_Hex_socket_head_cap_screw_M3x050_x_6 | (fuzzy: Hex socket head cap screw M3x0.50 x 6) | BOM Mass | Stainless Steel | 0.11 | 0.0008 | FOUND | ⚠️ Fuzzy matched to BOM entry 'Hex socket head cap screw M3x0.50 x 6' |
| left_arm_1_l4_ASM_2_Hex_socket_head_cap_screw_M3x050_x_6 | (fuzzy: Hex socket head cap screw M3x0.50 x 6) | BOM Mass | Stainless Steel | 0.11 | 0.0008 | FOUND | ⚠️ Fuzzy matched to BOM entry 'Hex socket head cap screw M3x0.50 x 6' |
| left_arm_1_l4_ASM_2_Hex_socket_head_cap_screw_M3x050_x_6 | (fuzzy: Hex socket head cap screw M3x0.50 x 6) | BOM Mass | Stainless Steel | 0.11 | 0.0008 | FOUND | ⚠️ Fuzzy matched to BOM entry 'Hex socket head cap screw M3x0.50 x 6' |
| left_arm_1_l4_ASM_2_Hex_socket_head_cap_screw_M3x050_x_6 | (fuzzy: Hex socket head cap screw M3x0.50 x 6) | BOM Mass | Stainless Steel | 0.11 | 0.0008 | FOUND | ⚠️ Fuzzy matched to BOM entry 'Hex socket head cap screw M3x0.50 x 6' |
| left_arm_1_l4_ASM_2_Hex_socket_head_cap_screw_M3x050_x_6 | (fuzzy: Hex socket head cap screw M3x0.50 x 6) | BOM Mass | Stainless Steel | 0.11 | 0.0008 | FOUND | ⚠️ Fuzzy matched to BOM entry 'Hex socket head cap screw M3x0.50 x 6' |
| left_arm_1_l4_ASM_2_Hex_socket_head_cap_screw_M3x050_x_6 | (fuzzy: Hex socket head cap screw M3x0.50 x 6) | BOM Mass | Stainless Steel | 0.11 | 0.0008 | FOUND | ⚠️ Fuzzy matched to BOM entry 'Hex socket head cap screw M3x0.50 x 6' |
| left_arm_1_l4_ASM_2_Hex_socket_head_cap_screw_M3x050_x_6 | (fuzzy: Hex socket head cap screw M3x0.50 x 6) | BOM Mass | Stainless Steel | 0.11 | 0.0008 | FOUND | ⚠️ Fuzzy matched to BOM entry 'Hex socket head cap screw M3x0.50 x 6' |
| left_arm_1_l4_ASM_2_Hex_socket_head_cap_screw_M3x050_x_6 | (fuzzy: Hex socket head cap screw M3x0.50 x 6) | BOM Mass | Stainless Steel | 0.11 | 0.0008 | FOUND | ⚠️ Fuzzy matched to BOM entry 'Hex socket head cap screw M3x0.50 x 6' |
| left_arm_1_l4_ASM_2_J4_D | (fuzzy: J4_D) | BOM Mass | Stainless Steel 304 | 9.67 | 0.0777 | FOUND | ⚠️ Fuzzy matched to BOM entry 'J4_D' |
| left_arm_1_l4_ASM_2_Hex_socket_head_cap_screw_M3x050_x_8 | (fuzzy: Hex socket head cap screw M3x0.50 x 8) | BOM Mass | Stainless Steel | 0.12 | 0.0009 | FOUND | ⚠️ Fuzzy matched to BOM entry 'Hex socket head cap screw M3x0.50 x 8' |
| left_arm_1_l4_ASM_2_Hex_socket_head_cap_screw_M3x050_x_8 | (fuzzy: Hex socket head cap screw M3x0.50 x 8) | BOM Mass | Stainless Steel | 0.12 | 0.0009 | FOUND | ⚠️ Fuzzy matched to BOM entry 'Hex socket head cap screw M3x0.50 x 8' |
| left_arm_1_l4_ASM_2_Hex_socket_head_cap_screw_M3x050_x_6 | (fuzzy: Hex socket head cap screw M3x0.50 x 6) | BOM Mass | Stainless Steel | 0.11 | 0.0008 | FOUND | ⚠️ Fuzzy matched to BOM entry 'Hex socket head cap screw M3x0.50 x 6' |
| left_arm_1_l4_ASM_2_Hex_socket_head_cap_screw_M3x050_x_6 | (fuzzy: Hex socket head cap screw M3x0.50 x 6) | BOM Mass | Stainless Steel | 0.11 | 0.0008 | FOUND | ⚠️ Fuzzy matched to BOM entry 'Hex socket head cap screw M3x0.50 x 6' |
| left_arm_1_l4_ASM_2_Hex_socket_head_cap_screw_M3x050_x_6 | (fuzzy: Hex socket head cap screw M3x0.50 x 6) | BOM Mass | Stainless Steel | 0.11 | 0.0008 | FOUND | ⚠️ Fuzzy matched to BOM entry 'Hex socket head cap screw M3x0.50 x 6' |

**Link Total:** 0.5166 kg
**Warnings:** 28 parts with issues

---

## Link: left_arm_l5

| Part | BOM Match | Mass Source | Material | Volume (cm³) | Mass (kg) | Mesh Match | Status |
|---|---|---|---|---|---|---|---|
| left_arm_1_l5_left_ASM_1_J5_A | (fuzzy: J5_A) | BOM Mass | ppa-cf | 12.65 | 0.0158 | FOUND | ⚠️ Fuzzy matched to BOM entry 'J5_A' |
| left_arm_1_l5_left_ASM_1_J6_B | (fuzzy: J6_B) | BOM Mass | Stainless Steel 304 | 5.37 | 0.0431 | FOUND | ⚠️ Fuzzy matched to BOM entry 'J6_B' |
| left_arm_1_l5_left_ASM_1_J6_A | (fuzzy: J6_A) | BOM Mass | Stainless Steel 304 | 6.73 | 0.0540 | FOUND | ⚠️ Fuzzy matched to BOM entry 'J6_A' |
| left_arm_1_l5_left_ASM_1_Hex_socket_head_cap_screw_M3x050_x_18 | (fuzzy: Hex socket head cap screw M3x0.50 x 18) | BOM Mass | Stainless Steel | 0.19 | 0.0015 | FOUND | ⚠️ Fuzzy matched to BOM entry 'Hex socket head cap screw M3x0.50 x 18' |
| left_arm_1_l5_left_ASM_1_Hex_socket_head_cap_screw_M3x050_x_18 | (fuzzy: Hex socket head cap screw M3x0.50 x 18) | BOM Mass | Stainless Steel | 0.19 | 0.0015 | FOUND | ⚠️ Fuzzy matched to BOM entry 'Hex socket head cap screw M3x0.50 x 18' |
| left_arm_1_l5_left_ASM_1_Hex_socket_head_cap_screw_M3x050_x_18 | (fuzzy: Hex socket head cap screw M3x0.50 x 18) | BOM Mass | Stainless Steel | 0.19 | 0.0015 | FOUND | ⚠️ Fuzzy matched to BOM entry 'Hex socket head cap screw M3x0.50 x 18' |
| left_arm_1_l5_left_ASM_1_Hex_socket_head_cap_screw_M3x050_x_18 | (fuzzy: Hex socket head cap screw M3x0.50 x 18) | BOM Mass | Stainless Steel | 0.19 | 0.0015 | FOUND | ⚠️ Fuzzy matched to BOM entry 'Hex socket head cap screw M3x0.50 x 18' |
| left_arm_1_l5_left_ASM_1_Hex_socket_head_cap_screw_M3x050_x_18 | (fuzzy: Hex socket head cap screw M3x0.50 x 18) | BOM Mass | Stainless Steel | 0.19 | 0.0015 | FOUND | ⚠️ Fuzzy matched to BOM entry 'Hex socket head cap screw M3x0.50 x 18' |
| left_arm_1_l5_left_ASM_1_Hex_socket_head_cap_screw_M3x050_x_18 | (fuzzy: Hex socket head cap screw M3x0.50 x 18) | BOM Mass | Stainless Steel | 0.19 | 0.0015 | FOUND | ⚠️ Fuzzy matched to BOM entry 'Hex socket head cap screw M3x0.50 x 18' |
| left_arm_1_l5_left_ASM_1_J6_C_left | (fuzzy: J6_C_left) | BOM Mass | Stainless Steel 304 | 2.12 | 0.0170 | FOUND | ⚠️ Fuzzy matched to BOM entry 'J6_C_left' |
| left_arm_1_l5_left_ASM_1_Hex_socket_head_cap_screw_M3x050_x_8 | (fuzzy: Hex socket head cap screw M3x0.50 x 8) | BOM Mass | Stainless Steel | 0.12 | 0.0009 | FOUND | ⚠️ Fuzzy matched to BOM entry 'Hex socket head cap screw M3x0.50 x 8' |
| left_arm_1_l5_left_ASM_1_Hex_socket_head_cap_screw_M3x050_x_8 | (fuzzy: Hex socket head cap screw M3x0.50 x 8) | BOM Mass | Stainless Steel | 0.12 | 0.0009 | FOUND | ⚠️ Fuzzy matched to BOM entry 'Hex socket head cap screw M3x0.50 x 8' |
| left_arm_1_l5_left_ASM_1_Hex_socket_head_cap_screw_M3x050_x_8 | (fuzzy: Hex socket head cap screw M3x0.50 x 8) | BOM Mass | Stainless Steel | 0.12 | 0.0009 | FOUND | ⚠️ Fuzzy matched to BOM entry 'Hex socket head cap screw M3x0.50 x 8' |
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
| left_arm_1_l5_left_ASM_1_Hex_socket_head_cap_screw_M3x050_x_6 | (fuzzy: Hex socket head cap screw M3x0.50 x 6) | BOM Mass | Stainless Steel | 0.11 | 0.0008 | FOUND | ⚠️ Fuzzy matched to BOM entry 'Hex socket head cap screw M3x0.50 x 6' |
| left_arm_1_l5_left_ASM_1_Hex_socket_head_cap_screw_M3x050_x_6 | (fuzzy: Hex socket head cap screw M3x0.50 x 6) | BOM Mass | Stainless Steel | 0.11 | 0.0008 | FOUND | ⚠️ Fuzzy matched to BOM entry 'Hex socket head cap screw M3x0.50 x 6' |
| left_arm_1_l5_left_ASM_1_Hex_socket_head_cap_screw_M3x050_x_6 | (fuzzy: Hex socket head cap screw M3x0.50 x 6) | BOM Mass | Stainless Steel | 0.11 | 0.0008 | FOUND | ⚠️ Fuzzy matched to BOM entry 'Hex socket head cap screw M3x0.50 x 6' |
| left_arm_1_l5_left_ASM_1_Hex_socket_head_cap_screw_M3x050_x_6 | (fuzzy: Hex socket head cap screw M3x0.50 x 6) | BOM Mass | Stainless Steel | 0.11 | 0.0008 | FOUND | ⚠️ Fuzzy matched to BOM entry 'Hex socket head cap screw M3x0.50 x 6' |
| left_arm_1_l5_left_ASM_1_Hex_socket_head_cap_screw_M3x050_x_6 | (fuzzy: Hex socket head cap screw M3x0.50 x 6) | BOM Mass | Stainless Steel | 0.11 | 0.0008 | FOUND | ⚠️ Fuzzy matched to BOM entry 'Hex socket head cap screw M3x0.50 x 6' |

**Link Total:** 0.4821 kg
**Warnings:** 38 parts with issues

---

## Link: left_arm_l6

| Part | BOM Match | Mass Source | Material | Volume (cm³) | Mass (kg) | Mesh Match | Status |
|---|---|---|---|---|---|---|---|
| left_arm_1_l6_URDF_1_J7_AB | (fuzzy: J7_AB) | BOM Mass | PETG | 29.36 | 0.0382 | FOUND | ⚠️ Fuzzy matched to BOM entry 'J7_AB' |
| left_arm_1_l6_URDF_1_4310 | (fuzzy: 4310) | BOM Mass | - | 109.88 | 0.3000 | FOUND | ⚠️ Fuzzy matched to BOM entry '4310' |
| left_arm_1_l6_URDF_1_Hex_socket_head_cap_screw_M3x050_x_8 | (fuzzy: Hex socket head cap screw M3x0.50 x 8) | BOM Mass | Stainless Steel | 0.12 | 0.0009 | FOUND | ⚠️ Fuzzy matched to BOM entry 'Hex socket head cap screw M3x0.50 x 8' |
| left_arm_1_l6_URDF_1_Hex_socket_head_cap_screw_M3x050_x_8 | (fuzzy: Hex socket head cap screw M3x0.50 x 8) | BOM Mass | Stainless Steel | 0.12 | 0.0009 | FOUND | ⚠️ Fuzzy matched to BOM entry 'Hex socket head cap screw M3x0.50 x 8' |
| left_arm_1_l6_URDF_1_Hex_socket_head_cap_screw_M3x050_x_8 | (fuzzy: Hex socket head cap screw M3x0.50 x 8) | BOM Mass | Stainless Steel | 0.12 | 0.0009 | FOUND | ⚠️ Fuzzy matched to BOM entry 'Hex socket head cap screw M3x0.50 x 8' |
| left_arm_1_l6_URDF_1_J7_C | (fuzzy: J7_C) | BOM Mass | Aluminum - 6061 | 3.20 | 0.0087 | FOUND | ⚠️ Fuzzy matched to BOM entry 'J7_C' |
| left_arm_1_l6_URDF_1_Hex_socket_head_cap_screw_M3x050_x_8 | (fuzzy: Hex socket head cap screw M3x0.50 x 8) | BOM Mass | Stainless Steel | 0.12 | 0.0009 | FOUND | ⚠️ Fuzzy matched to BOM entry 'Hex socket head cap screw M3x0.50 x 8' |
| left_arm_1_l6_URDF_1_Hex_socket_head_cap_screw_M3x050_x_8 | (fuzzy: Hex socket head cap screw M3x0.50 x 8) | BOM Mass | Stainless Steel | 0.12 | 0.0009 | FOUND | ⚠️ Fuzzy matched to BOM entry 'Hex socket head cap screw M3x0.50 x 8' |

**Link Total:** 0.3515 kg
**Warnings:** 8 parts with issues

---

## Link: left_arm_l7

| Part | BOM Match | Mass Source | Material | Volume (cm³) | Mass (kg) | Mesh Match | Status |
|---|---|---|---|---|---|---|---|
| left_arm_1_J8_A | (fuzzy: J8_A) | BOM Mass | Aluminum - 6061 | 13.49 | 0.0367 | FOUND | ⚠️ Fuzzy matched to BOM entry 'J8_A' |
| left_arm_1_gripper_1_J8_B | (fuzzy: J8_B) | BOM Mass | ppa-cf | 19.97 | 0.0218 | FOUND | ⚠️ Fuzzy matched to BOM entry 'J8_B' |
| left_arm_1_gripper_1_4310 | (fuzzy: 4310) | BOM Mass | - | 109.88 | 0.3000 | FOUND | ⚠️ Fuzzy matched to BOM entry '4310' |
| left_arm_1_gripper_1_J8_B | (fuzzy: J8_B) | BOM Mass | ppa-cf | 19.97 | 0.0218 | FOUND | ⚠️ Fuzzy matched to BOM entry 'J8_B' |
| left_arm_1_gripper_1_rail_connector | - | Default Density | - | 8.46 | 0.0085 | FOUND | ⚠️ Not found in BOM |
| left_arm_1_gripper_1_swivel_rotor | - | Default Density | - | 11.95 | 0.0120 | FOUND | ⚠️ Not found in BOM |
| left_arm_1_gripper_1_J8_A | (fuzzy: J8_A) | BOM Mass | Aluminum - 6061 | 13.49 | 0.0367 | FOUND | ⚠️ Fuzzy matched to BOM entry 'J8_A' |
| left_arm_1_gripper_1_rse2b10-155_rail_v3 | - | Default Density | - | 6.22 | 0.0062 | FOUND | ⚠️ Not found in BOM |
| left_arm_1_gripper_1_swivel_link | - | Default Density | - | 1.39 | 0.0014 | FOUND | ⚠️ Not found in BOM |
| left_arm_1_gripper_1_swivel_link | - | Default Density | - | 1.39 | 0.0014 | FOUND | ⚠️ Not found in BOM |
| left_arm_1_gripper_1_rse2b10-155_block_v3 | - | Default Density | - | 3.52 | 0.0035 | FOUND | ⚠️ Not found in BOM |
| left_arm_1_gripper_1_rse2b10-155_block_v3 | - | Default Density | - | 3.52 | 0.0035 | FOUND | ⚠️ Not found in BOM |
| left_arm_1_gripper_1_rail_CNC_attachment | - | Default Density | - | 6.25 | 0.0063 | FOUND | ⚠️ Not found in BOM |
| left_arm_1_gripper_1_rail_CNC_attachment | - | Default Density | - | 6.25 | 0.0063 | FOUND | ⚠️ Not found in BOM |
| left_arm_1_gripper_1_left_jaw | - | Default Density | - | 27.86 | 0.0279 | FOUND | ⚠️ Not found in BOM |
| left_arm_1_gripper_1_right_jaw | - | Default Density | - | 27.86 | 0.0279 | FOUND | ⚠️ Not found in BOM |

**Link Total:** 0.5217 kg
**Warnings:** 16 parts with issues

---

## Link: right_arm_l1

| Part | BOM Match | Mass Source | Material | Volume (cm³) | Mass (kg) | Mesh Match | Status |
|---|---|---|---|---|---|---|---|
| right_arm_1_l1_ASM_2_J1_C | (fuzzy: J1_C) | BOM Mass | Aluminum - 6061 | 23.08 | 0.0628 | FOUND | ⚠️ Fuzzy matched to BOM entry 'J1_C' |
| right_arm_1_l1_ASM_2_J1_D | (fuzzy: J1_D) | BOM Mass | Stainless Steel 304 | 3.51 | 0.0282 | FOUND | ⚠️ Fuzzy matched to BOM entry 'J1_D' |
| right_arm_1_l1_ASM_2_J1_E | (fuzzy: J1_E) | BOM Mass | Stainless Steel 304 | 3.86 | 0.0310 | FOUND | ⚠️ Fuzzy matched to BOM entry 'J1_E' |
| right_arm_1_l1_ASM_2_Hex_socket_head_cap_screw_M5x080_x_10 | (fuzzy: Hex socket head cap screw M5x0.80 x 10) | BOM Mass | Stainless Steel | 0.44 | 0.0034 | FOUND | ⚠️ Fuzzy matched to BOM entry 'Hex socket head cap screw M5x0.80 x 10' |
| right_arm_1_l1_ASM_2_Hex_socket_head_cap_screw_M5x080_x_10 | (fuzzy: Hex socket head cap screw M5x0.80 x 10) | BOM Mass | Stainless Steel | 0.44 | 0.0034 | FOUND | ⚠️ Fuzzy matched to BOM entry 'Hex socket head cap screw M5x0.80 x 10' |
| right_arm_1_l1_ASM_2_Hex_socket_head_cap_screw_M5x080_x_10 | (fuzzy: Hex socket head cap screw M5x0.80 x 10) | BOM Mass | Stainless Steel | 0.44 | 0.0034 | FOUND | ⚠️ Fuzzy matched to BOM entry 'Hex socket head cap screw M5x0.80 x 10' |
| right_arm_1_l1_ASM_2_Hex_socket_head_cap_screw_M5x080_x_10 | (fuzzy: Hex socket head cap screw M5x0.80 x 10) | BOM Mass | Stainless Steel | 0.44 | 0.0034 | FOUND | ⚠️ Fuzzy matched to BOM entry 'Hex socket head cap screw M5x0.80 x 10' |
| right_arm_1_l1_ASM_2_Hex_socket_head_cap_screw_M5x080_x_10 | (fuzzy: Hex socket head cap screw M5x0.80 x 10) | BOM Mass | Stainless Steel | 0.44 | 0.0034 | FOUND | ⚠️ Fuzzy matched to BOM entry 'Hex socket head cap screw M5x0.80 x 10' |
| right_arm_1_l1_ASM_2_Hex_socket_head_cap_screw_M4x070_x_10 | (fuzzy: Hex socket head cap screw M4x0.70 x 10) | BOM Mass | Stainless Steel | 0.26 | 0.0020 | FOUND | ⚠️ Fuzzy matched to BOM entry 'Hex socket head cap screw M4x0.70 x 10' |
| right_arm_1_l1_ASM_2_Hex_socket_head_cap_screw_M4x070_x_10 | (fuzzy: Hex socket head cap screw M4x0.70 x 10) | BOM Mass | Stainless Steel | 0.26 | 0.0020 | FOUND | ⚠️ Fuzzy matched to BOM entry 'Hex socket head cap screw M4x0.70 x 10' |
| right_arm_1_l1_ASM_2_Hex_socket_head_cap_screw_M4x070_x_8 | (fuzzy: Hex socket head cap screw M4x0.70 x 8) | BOM Mass | Stainless Steel | 0.24 | 0.0018 | FOUND | ⚠️ Fuzzy matched to BOM entry 'Hex socket head cap screw M4x0.70 x 8' |
| right_arm_1_l1_ASM_2_Hex_socket_head_cap_screw_M4x070_x_8 | (fuzzy: Hex socket head cap screw M4x0.70 x 8) | BOM Mass | Stainless Steel | 0.24 | 0.0018 | FOUND | ⚠️ Fuzzy matched to BOM entry 'Hex socket head cap screw M4x0.70 x 8' |
| right_arm_1_l1_ASM_2_Hex_socket_head_cap_screw_M4x070_x_8 | (fuzzy: Hex socket head cap screw M4x0.70 x 8) | BOM Mass | Stainless Steel | 0.24 | 0.0018 | FOUND | ⚠️ Fuzzy matched to BOM entry 'Hex socket head cap screw M4x0.70 x 8' |
| right_arm_1_l1_ASM_2_DM-J8009P-2EC | (fuzzy: DM-J8009P-2EC) | BOM Mass | - | 387.45 | 0.9210 | FOUND | ⚠️ Fuzzy matched to BOM entry 'DM-J8009P-2EC' |
| right_arm_1_l1_ASM_2_Hex_socket_head_cap_screw_M4x070_x_10 | (fuzzy: Hex socket head cap screw M4x0.70 x 10) | BOM Mass | Stainless Steel | 0.26 | 0.0020 | FOUND | ⚠️ Fuzzy matched to BOM entry 'Hex socket head cap screw M4x0.70 x 10' |
| right_arm_1_l1_ASM_2_Hex_socket_head_cap_screw_M4x070_x_10 | (fuzzy: Hex socket head cap screw M4x0.70 x 10) | BOM Mass | Stainless Steel | 0.26 | 0.0020 | FOUND | ⚠️ Fuzzy matched to BOM entry 'Hex socket head cap screw M4x0.70 x 10' |
| right_arm_1_l1_ASM_2_Hex_socket_head_cap_screw_M4x070_x_10 | (fuzzy: Hex socket head cap screw M4x0.70 x 10) | BOM Mass | Stainless Steel | 0.26 | 0.0020 | FOUND | ⚠️ Fuzzy matched to BOM entry 'Hex socket head cap screw M4x0.70 x 10' |
| right_arm_1_l1_ASM_2_Hex_socket_head_cap_screw_M4x070_x_8 | (fuzzy: Hex socket head cap screw M4x0.70 x 8) | BOM Mass | Stainless Steel | 0.24 | 0.0018 | FOUND | ⚠️ Fuzzy matched to BOM entry 'Hex socket head cap screw M4x0.70 x 8' |

**Link Total:** 1.0775 kg
**Warnings:** 18 parts with issues

---

## Link: right_arm_l2

| Part | BOM Match | Mass Source | Material | Volume (cm³) | Mass (kg) | Mesh Match | Status |
|---|---|---|---|---|---|---|---|
| right_arm_1_l2_ASM_2_J2_A | (fuzzy: J2_A) | BOM Mass | Stainless Steel 304 | 14.18 | 0.1138 | FOUND | ⚠️ Fuzzy matched to BOM entry 'J2_A' |
| right_arm_1_l2_ASM_2_J2_C | (fuzzy: J2_C) | BOM Mass | Stainless Steel 304 | 4.05 | 0.0325 | FOUND | ⚠️ Fuzzy matched to BOM entry 'J2_C' |
| right_arm_1_l2_ASM_2_Hex_socket_head_cap_screw_M4x070_x_10 | (fuzzy: Hex socket head cap screw M4x0.70 x 10) | BOM Mass | Stainless Steel | 0.26 | 0.0020 | FOUND | ⚠️ Fuzzy matched to BOM entry 'Hex socket head cap screw M4x0.70 x 10' |
| right_arm_1_l2_ASM_2_Hex_socket_head_cap_screw_M5x080_x_10 | (fuzzy: Hex socket head cap screw M5x0.80 x 10) | BOM Mass | Stainless Steel | 0.44 | 0.0034 | FOUND | ⚠️ Fuzzy matched to BOM entry 'Hex socket head cap screw M5x0.80 x 10' |
| right_arm_1_l2_ASM_2_Hex_socket_head_cap_screw_M5x080_x_10 | (fuzzy: Hex socket head cap screw M5x0.80 x 10) | BOM Mass | Stainless Steel | 0.44 | 0.0034 | FOUND | ⚠️ Fuzzy matched to BOM entry 'Hex socket head cap screw M5x0.80 x 10' |
| right_arm_1_l2_ASM_2_Hex_socket_head_cap_screw_M5x080_x_10 | (fuzzy: Hex socket head cap screw M5x0.80 x 10) | BOM Mass | Stainless Steel | 0.44 | 0.0034 | FOUND | ⚠️ Fuzzy matched to BOM entry 'Hex socket head cap screw M5x0.80 x 10' |
| right_arm_1_l2_ASM_2_Hex_socket_head_cap_screw_M5x080_x_10 | (fuzzy: Hex socket head cap screw M5x0.80 x 10) | BOM Mass | Stainless Steel | 0.44 | 0.0034 | FOUND | ⚠️ Fuzzy matched to BOM entry 'Hex socket head cap screw M5x0.80 x 10' |
| right_arm_1_l2_ASM_2_Hex_socket_head_cap_screw_M5x080_x_10 | (fuzzy: Hex socket head cap screw M5x0.80 x 10) | BOM Mass | Stainless Steel | 0.44 | 0.0034 | FOUND | ⚠️ Fuzzy matched to BOM entry 'Hex socket head cap screw M5x0.80 x 10' |
| right_arm_1_l2_ASM_2_Hex_socket_head_cap_screw_M5x080_x_10 | (fuzzy: Hex socket head cap screw M5x0.80 x 10) | BOM Mass | Stainless Steel | 0.44 | 0.0034 | FOUND | ⚠️ Fuzzy matched to BOM entry 'Hex socket head cap screw M5x0.80 x 10' |
| right_arm_1_l2_ASM_2_Hex_socket_head_cap_screw_M3x050_x_8 | (fuzzy: Hex socket head cap screw M3x0.50 x 8) | BOM Mass | Stainless Steel | 0.12 | 0.0009 | FOUND | ⚠️ Fuzzy matched to BOM entry 'Hex socket head cap screw M3x0.50 x 8' |
| right_arm_1_l2_ASM_2_J2_B | (fuzzy: J2_B) | BOM Mass | Aluminum - 6061 | 22.81 | 0.0620 | FOUND | ⚠️ Fuzzy matched to BOM entry 'J2_B' |
| right_arm_1_l2_ASM_2_Hex_socket_head_cap_screw_M4x070_x_6 | (fuzzy: Hex socket head cap screw M4x0.70 x 6) | BOM Mass | Stainless Steel | 0.21 | 0.0016 | FOUND | ⚠️ Fuzzy matched to BOM entry 'Hex socket head cap screw M4x0.70 x 6' |
| right_arm_1_l2_ASM_2_Hex_socket_head_cap_screw_M4x070_x_6 | (fuzzy: Hex socket head cap screw M4x0.70 x 6) | BOM Mass | Stainless Steel | 0.21 | 0.0016 | FOUND | ⚠️ Fuzzy matched to BOM entry 'Hex socket head cap screw M4x0.70 x 6' |
| right_arm_1_l2_ASM_2_Hex_socket_head_cap_screw_M4x070_x_6 | (fuzzy: Hex socket head cap screw M4x0.70 x 6) | BOM Mass | Stainless Steel | 0.21 | 0.0016 | FOUND | ⚠️ Fuzzy matched to BOM entry 'Hex socket head cap screw M4x0.70 x 6' |
| right_arm_1_l2_ASM_2_Hex_socket_head_cap_screw_M4x070_x_6 | (fuzzy: Hex socket head cap screw M4x0.70 x 6) | BOM Mass | Stainless Steel | 0.21 | 0.0016 | FOUND | ⚠️ Fuzzy matched to BOM entry 'Hex socket head cap screw M4x0.70 x 6' |
| right_arm_1_l2_ASM_2_Hex_socket_head_cap_screw_M4x070_x_6 | (fuzzy: Hex socket head cap screw M4x0.70 x 6) | BOM Mass | Stainless Steel | 0.21 | 0.0016 | FOUND | ⚠️ Fuzzy matched to BOM entry 'Hex socket head cap screw M4x0.70 x 6' |
| right_arm_1_l2_ASM_2_Hex_socket_head_cap_screw_M4x070_x_6 | (fuzzy: Hex socket head cap screw M4x0.70 x 6) | BOM Mass | Stainless Steel | 0.21 | 0.0016 | FOUND | ⚠️ Fuzzy matched to BOM entry 'Hex socket head cap screw M4x0.70 x 6' |
| right_arm_1_l2_ASM_2_Hex_socket_head_cap_screw_M4x070_x_6 | (fuzzy: Hex socket head cap screw M4x0.70 x 6) | BOM Mass | Stainless Steel | 0.21 | 0.0016 | FOUND | ⚠️ Fuzzy matched to BOM entry 'Hex socket head cap screw M4x0.70 x 6' |
| right_arm_1_l2_ASM_2_Hex_socket_head_cap_screw_M4x070_x_6 | (fuzzy: Hex socket head cap screw M4x0.70 x 6) | BOM Mass | Stainless Steel | 0.21 | 0.0016 | FOUND | ⚠️ Fuzzy matched to BOM entry 'Hex socket head cap screw M4x0.70 x 6' |
| right_arm_1_l2_ASM_2_Hex_socket_head_cap_screw_M3x050_x_14 | (fuzzy: Hex socket head cap screw M3x0.50 x 14) | BOM Mass | Stainless Steel | 0.16 | 0.0013 | FOUND | ⚠️ Fuzzy matched to BOM entry 'Hex socket head cap screw M3x0.50 x 14' |
| right_arm_1_l2_ASM_2_Hex_socket_head_cap_screw_M3x050_x_14 | (fuzzy: Hex socket head cap screw M3x0.50 x 14) | BOM Mass | Stainless Steel | 0.16 | 0.0013 | FOUND | ⚠️ Fuzzy matched to BOM entry 'Hex socket head cap screw M3x0.50 x 14' |
| right_arm_1_l2_ASM_2_Hex_socket_head_cap_screw_M3x050_x_14 | (fuzzy: Hex socket head cap screw M3x0.50 x 14) | BOM Mass | Stainless Steel | 0.16 | 0.0013 | FOUND | ⚠️ Fuzzy matched to BOM entry 'Hex socket head cap screw M3x0.50 x 14' |
| right_arm_1_l2_ASM_2_Hex_socket_head_cap_screw_M3x050_x_14 | (fuzzy: Hex socket head cap screw M3x0.50 x 14) | BOM Mass | Stainless Steel | 0.16 | 0.0013 | FOUND | ⚠️ Fuzzy matched to BOM entry 'Hex socket head cap screw M3x0.50 x 14' |
| right_arm_1_l2_ASM_2_Hex_socket_head_cap_screw_M3x050_x_14 | (fuzzy: Hex socket head cap screw M3x0.50 x 14) | BOM Mass | Stainless Steel | 0.16 | 0.0013 | FOUND | ⚠️ Fuzzy matched to BOM entry 'Hex socket head cap screw M3x0.50 x 14' |
| right_arm_1_l2_ASM_2_Hex_socket_head_cap_screw_M3x050_x_14 | (fuzzy: Hex socket head cap screw M3x0.50 x 14) | BOM Mass | Stainless Steel | 0.16 | 0.0013 | FOUND | ⚠️ Fuzzy matched to BOM entry 'Hex socket head cap screw M3x0.50 x 14' |

**Link Total:** 0.2526 kg
**Warnings:** 25 parts with issues

---

## Link: right_arm_l3

| Part | BOM Match | Mass Source | Material | Volume (cm³) | Mass (kg) | Mesh Match | Status |
|---|---|---|---|---|---|---|---|
| right_arm_1_l3_ASM_2_4340P | (fuzzy: 4340P) | BOM Mass | - | 135.71 | 0.3750 | FOUND | ⚠️ Fuzzy matched to BOM entry '4340P' |
| right_arm_1_l3_ASM_2_J4_A | (fuzzy: J4_A) | BOM Mass | Stainless Steel 304 | 23.37 | 0.1877 | FOUND | ⚠️ Fuzzy matched to BOM entry 'J4_A' |
| right_arm_1_l3_ASM_2_4340 | (fuzzy: 4340) | BOM Mass | - | 128.48 | 0.3620 | FOUND | ⚠️ Fuzzy matched to BOM entry '4340' |
| right_arm_1_l3_ASM_2_Hex_socket_head_cap_screw_M3x050_x_6 | (fuzzy: Hex socket head cap screw M3x0.50 x 6) | BOM Mass | Stainless Steel | 0.11 | 0.0008 | FOUND | ⚠️ Fuzzy matched to BOM entry 'Hex socket head cap screw M3x0.50 x 6' |
| right_arm_1_l3_ASM_2_Hex_socket_head_cap_screw_M3x050_x_6 | (fuzzy: Hex socket head cap screw M3x0.50 x 6) | BOM Mass | Stainless Steel | 0.11 | 0.0008 | FOUND | ⚠️ Fuzzy matched to BOM entry 'Hex socket head cap screw M3x0.50 x 6' |
| right_arm_1_l3_ASM_2_Hex_socket_head_cap_screw_M3x050_x_6 | (fuzzy: Hex socket head cap screw M3x0.50 x 6) | BOM Mass | Stainless Steel | 0.11 | 0.0008 | FOUND | ⚠️ Fuzzy matched to BOM entry 'Hex socket head cap screw M3x0.50 x 6' |
| right_arm_1_l3_ASM_2_Hex_socket_head_cap_screw_M3x050_x_6 | (fuzzy: Hex socket head cap screw M3x0.50 x 6) | BOM Mass | Stainless Steel | 0.11 | 0.0008 | FOUND | ⚠️ Fuzzy matched to BOM entry 'Hex socket head cap screw M3x0.50 x 6' |
| right_arm_1_l3_ASM_2_Hex_socket_head_cap_screw_M3x050_x_6 | (fuzzy: Hex socket head cap screw M3x0.50 x 6) | BOM Mass | Stainless Steel | 0.11 | 0.0008 | FOUND | ⚠️ Fuzzy matched to BOM entry 'Hex socket head cap screw M3x0.50 x 6' |
| right_arm_1_l3_ASM_2_Hex_socket_head_cap_screw_M3x050_x_6 | (fuzzy: Hex socket head cap screw M3x0.50 x 6) | BOM Mass | Stainless Steel | 0.11 | 0.0008 | FOUND | ⚠️ Fuzzy matched to BOM entry 'Hex socket head cap screw M3x0.50 x 6' |
| right_arm_1_l3_ASM_2_Hex_socket_head_cap_screw_M3x050_x_6 | (fuzzy: Hex socket head cap screw M3x0.50 x 6) | BOM Mass | Stainless Steel | 0.11 | 0.0008 | FOUND | ⚠️ Fuzzy matched to BOM entry 'Hex socket head cap screw M3x0.50 x 6' |
| right_arm_1_l3_ASM_2_Hex_socket_head_cap_screw_M3x050_x_6 | (fuzzy: Hex socket head cap screw M3x0.50 x 6) | BOM Mass | Stainless Steel | 0.11 | 0.0008 | FOUND | ⚠️ Fuzzy matched to BOM entry 'Hex socket head cap screw M3x0.50 x 6' |
| right_arm_1_l3_ASM_2_Hex_socket_head_cap_screw_M3x050_x_6 | (fuzzy: Hex socket head cap screw M3x0.50 x 6) | BOM Mass | Stainless Steel | 0.11 | 0.0008 | FOUND | ⚠️ Fuzzy matched to BOM entry 'Hex socket head cap screw M3x0.50 x 6' |
| right_arm_1_l3_ASM_2_Hex_socket_head_cap_screw_M3x050_x_6 | (fuzzy: Hex socket head cap screw M3x0.50 x 6) | BOM Mass | Stainless Steel | 0.11 | 0.0008 | FOUND | ⚠️ Fuzzy matched to BOM entry 'Hex socket head cap screw M3x0.50 x 6' |
| right_arm_1_l3_ASM_2_Hex_socket_head_cap_screw_M3x050_x_6 | (fuzzy: Hex socket head cap screw M3x0.50 x 6) | BOM Mass | Stainless Steel | 0.11 | 0.0008 | FOUND | ⚠️ Fuzzy matched to BOM entry 'Hex socket head cap screw M3x0.50 x 6' |
| right_arm_1_l3_ASM_2_Hex_socket_head_cap_screw_M3x050_x_6 | (fuzzy: Hex socket head cap screw M3x0.50 x 6) | BOM Mass | Stainless Steel | 0.11 | 0.0008 | FOUND | ⚠️ Fuzzy matched to BOM entry 'Hex socket head cap screw M3x0.50 x 6' |
| right_arm_1_l3_ASM_2_Hex_socket_head_cap_screw_M3x050_x_6 | (fuzzy: Hex socket head cap screw M3x0.50 x 6) | BOM Mass | Stainless Steel | 0.11 | 0.0008 | FOUND | ⚠️ Fuzzy matched to BOM entry 'Hex socket head cap screw M3x0.50 x 6' |
| right_arm_1_l3_ASM_2_Hex_socket_head_cap_screw_M3x050_x_6 | (fuzzy: Hex socket head cap screw M3x0.50 x 6) | BOM Mass | Stainless Steel | 0.11 | 0.0008 | FOUND | ⚠️ Fuzzy matched to BOM entry 'Hex socket head cap screw M3x0.50 x 6' |
| right_arm_1_l3_ASM_2_Hex_socket_head_cap_screw_M3x050_x_6 | (fuzzy: Hex socket head cap screw M3x0.50 x 6) | BOM Mass | Stainless Steel | 0.11 | 0.0008 | FOUND | ⚠️ Fuzzy matched to BOM entry 'Hex socket head cap screw M3x0.50 x 6' |
| right_arm_1_l3_ASM_2_Hex_socket_head_cap_screw_M3x050_x_6 | (fuzzy: Hex socket head cap screw M3x0.50 x 6) | BOM Mass | Stainless Steel | 0.11 | 0.0008 | FOUND | ⚠️ Fuzzy matched to BOM entry 'Hex socket head cap screw M3x0.50 x 6' |
| right_arm_1_l3_ASM_2_Hex_socket_head_cap_screw_M3x050_x_6 | (fuzzy: Hex socket head cap screw M3x0.50 x 6) | BOM Mass | Stainless Steel | 0.11 | 0.0008 | FOUND | ⚠️ Fuzzy matched to BOM entry 'Hex socket head cap screw M3x0.50 x 6' |
| right_arm_1_l3_ASM_2_Hex_socket_head_cap_screw_M3x050_x_6 | (fuzzy: Hex socket head cap screw M3x0.50 x 6) | BOM Mass | Stainless Steel | 0.11 | 0.0008 | FOUND | ⚠️ Fuzzy matched to BOM entry 'Hex socket head cap screw M3x0.50 x 6' |
| right_arm_1_l3_ASM_2_copper_pillar_61 | (fuzzy: copper pillar 61) | BOM Mass | Copper | 1.30 | 0.0116 | FOUND | ⚠️ Fuzzy matched to BOM entry 'copper pillar 61' |
| right_arm_1_l3_ASM_2_Hex_socket_head_cap_screw_M3x050_x_8 | (fuzzy: Hex socket head cap screw M3x0.50 x 8) | BOM Mass | Stainless Steel | 0.12 | 0.0009 | FOUND | ⚠️ Fuzzy matched to BOM entry 'Hex socket head cap screw M3x0.50 x 8' |
| right_arm_1_l3_ASM_2_Hex_socket_head_cap_screw_M3x050_x_8 | (fuzzy: Hex socket head cap screw M3x0.50 x 8) | BOM Mass | Stainless Steel | 0.12 | 0.0009 | FOUND | ⚠️ Fuzzy matched to BOM entry 'Hex socket head cap screw M3x0.50 x 8' |
| right_arm_1_l3_ASM_2_J4_B | (fuzzy: J4_B) | BOM Mass | ppa-cf | 25.43 | 0.0318 | FOUND | ⚠️ Fuzzy matched to BOM entry 'J4_B' |
| right_arm_1_l3_ASM_2_C-FL6803ZZ | (fuzzy: C-FL6803ZZ) | BOM Mass | - | 1.54 | 0.0000 | FOUND | ⚠️ Fuzzy matched to BOM entry 'C-FL6803ZZ' |
| right_arm_1_l3_ASM_2_Hex_socket_head_cap_screw_M3x050_x_6 | (fuzzy: Hex socket head cap screw M3x0.50 x 6) | BOM Mass | Stainless Steel | 0.11 | 0.0008 | FOUND | ⚠️ Fuzzy matched to BOM entry 'Hex socket head cap screw M3x0.50 x 6' |
| right_arm_1_l3_ASM_2_Hex_socket_head_cap_screw_M3x050_x_6 | (fuzzy: Hex socket head cap screw M3x0.50 x 6) | BOM Mass | Stainless Steel | 0.11 | 0.0008 | FOUND | ⚠️ Fuzzy matched to BOM entry 'Hex socket head cap screw M3x0.50 x 6' |
| right_arm_1_l3_ASM_2_Hex_socket_head_cap_screw_M3x050_x_6 | (fuzzy: Hex socket head cap screw M3x0.50 x 6) | BOM Mass | Stainless Steel | 0.11 | 0.0008 | FOUND | ⚠️ Fuzzy matched to BOM entry 'Hex socket head cap screw M3x0.50 x 6' |
| right_arm_1_l3_ASM_2_Hex_socket_head_cap_screw_M3x050_x_6 | (fuzzy: Hex socket head cap screw M3x0.50 x 6) | BOM Mass | Stainless Steel | 0.11 | 0.0008 | FOUND | ⚠️ Fuzzy matched to BOM entry 'Hex socket head cap screw M3x0.50 x 6' |

**Link Total:** 0.9880 kg
**Warnings:** 30 parts with issues

---

## Link: right_arm_l4

| Part | BOM Match | Mass Source | Material | Volume (cm³) | Mass (kg) | Mesh Match | Status |
|---|---|---|---|---|---|---|---|
| right_arm_1_l4_ASM_2_J4_C | (fuzzy: J4_C) | BOM Mass | Aluminum - 6061 | 4.54 | 0.0123 | FOUND | ⚠️ Fuzzy matched to BOM entry 'J4_C' |
| right_arm_1_l4_ASM_2_J4_E | (fuzzy: J4_E) | BOM Mass | Stainless Steel 304 | 9.95 | 0.0799 | FOUND | ⚠️ Fuzzy matched to BOM entry 'J4_E' |
| right_arm_1_l4_ASM_2_Hex_socket_head_cap_screw_M3x050_x_6 | (fuzzy: Hex socket head cap screw M3x0.50 x 6) | BOM Mass | Stainless Steel | 0.11 | 0.0008 | FOUND | ⚠️ Fuzzy matched to BOM entry 'Hex socket head cap screw M3x0.50 x 6' |
| right_arm_1_l4_ASM_2_Hex_socket_head_cap_screw_M3x050_x_6 | (fuzzy: Hex socket head cap screw M3x0.50 x 6) | BOM Mass | Stainless Steel | 0.11 | 0.0008 | FOUND | ⚠️ Fuzzy matched to BOM entry 'Hex socket head cap screw M3x0.50 x 6' |
| right_arm_1_l4_ASM_2_Hex_socket_head_cap_screw_M3x050_x_6 | (fuzzy: Hex socket head cap screw M3x0.50 x 6) | BOM Mass | Stainless Steel | 0.11 | 0.0008 | FOUND | ⚠️ Fuzzy matched to BOM entry 'Hex socket head cap screw M3x0.50 x 6' |
| right_arm_1_l4_ASM_2_Hex_socket_head_cap_screw_M3x050_x_6 | (fuzzy: Hex socket head cap screw M3x0.50 x 6) | BOM Mass | Stainless Steel | 0.11 | 0.0008 | FOUND | ⚠️ Fuzzy matched to BOM entry 'Hex socket head cap screw M3x0.50 x 6' |
| right_arm_1_l4_ASM_2_Hex_socket_head_cap_screw_M3x050_x_6 | (fuzzy: Hex socket head cap screw M3x0.50 x 6) | BOM Mass | Stainless Steel | 0.11 | 0.0008 | FOUND | ⚠️ Fuzzy matched to BOM entry 'Hex socket head cap screw M3x0.50 x 6' |
| right_arm_1_l4_ASM_2_Hex_socket_head_cap_screw_M3x050_x_6 | (fuzzy: Hex socket head cap screw M3x0.50 x 6) | BOM Mass | Stainless Steel | 0.11 | 0.0008 | FOUND | ⚠️ Fuzzy matched to BOM entry 'Hex socket head cap screw M3x0.50 x 6' |
| right_arm_1_l4_ASM_2_4310 | (fuzzy: 4310) | BOM Mass | - | 109.88 | 0.3000 | FOUND | ⚠️ Fuzzy matched to BOM entry '4310' |
| right_arm_1_l4_ASM_2_copper_pillar_742 | (fuzzy: copper pillar 74.2) | BOM Mass | Copper | 1.58 | 0.0141 | FOUND | ⚠️ Fuzzy matched to BOM entry 'copper pillar 74.2' |
| right_arm_1_l4_ASM_2_copper_pillar_742 | (fuzzy: copper pillar 74.2) | BOM Mass | Copper | 1.58 | 0.0141 | FOUND | ⚠️ Fuzzy matched to BOM entry 'copper pillar 74.2' |
| right_arm_1_l4_ASM_2_Hex_socket_head_cap_screw_M3x050_x_8 | (fuzzy: Hex socket head cap screw M3x0.50 x 8) | BOM Mass | Stainless Steel | 0.12 | 0.0009 | FOUND | ⚠️ Fuzzy matched to BOM entry 'Hex socket head cap screw M3x0.50 x 8' |
| right_arm_1_l4_ASM_2_Hex_socket_head_cap_screw_M3x050_x_8 | (fuzzy: Hex socket head cap screw M3x0.50 x 8) | BOM Mass | Stainless Steel | 0.12 | 0.0009 | FOUND | ⚠️ Fuzzy matched to BOM entry 'Hex socket head cap screw M3x0.50 x 8' |
| right_arm_1_l4_ASM_2_Hex_socket_head_cap_screw_M3x050_x_6 | (fuzzy: Hex socket head cap screw M3x0.50 x 6) | BOM Mass | Stainless Steel | 0.11 | 0.0008 | FOUND | ⚠️ Fuzzy matched to BOM entry 'Hex socket head cap screw M3x0.50 x 6' |
| right_arm_1_l4_ASM_2_Hex_socket_head_cap_screw_M3x050_x_6 | (fuzzy: Hex socket head cap screw M3x0.50 x 6) | BOM Mass | Stainless Steel | 0.11 | 0.0008 | FOUND | ⚠️ Fuzzy matched to BOM entry 'Hex socket head cap screw M3x0.50 x 6' |
| right_arm_1_l4_ASM_2_Hex_socket_head_cap_screw_M3x050_x_6 | (fuzzy: Hex socket head cap screw M3x0.50 x 6) | BOM Mass | Stainless Steel | 0.11 | 0.0008 | FOUND | ⚠️ Fuzzy matched to BOM entry 'Hex socket head cap screw M3x0.50 x 6' |
| right_arm_1_l4_ASM_2_Hex_socket_head_cap_screw_M3x050_x_6 | (fuzzy: Hex socket head cap screw M3x0.50 x 6) | BOM Mass | Stainless Steel | 0.11 | 0.0008 | FOUND | ⚠️ Fuzzy matched to BOM entry 'Hex socket head cap screw M3x0.50 x 6' |
| right_arm_1_l4_ASM_2_Hex_socket_head_cap_screw_M3x050_x_6 | (fuzzy: Hex socket head cap screw M3x0.50 x 6) | BOM Mass | Stainless Steel | 0.11 | 0.0008 | FOUND | ⚠️ Fuzzy matched to BOM entry 'Hex socket head cap screw M3x0.50 x 6' |
| right_arm_1_l4_ASM_2_Hex_socket_head_cap_screw_M3x050_x_6 | (fuzzy: Hex socket head cap screw M3x0.50 x 6) | BOM Mass | Stainless Steel | 0.11 | 0.0008 | FOUND | ⚠️ Fuzzy matched to BOM entry 'Hex socket head cap screw M3x0.50 x 6' |
| right_arm_1_l4_ASM_2_Hex_socket_head_cap_screw_M3x050_x_6 | (fuzzy: Hex socket head cap screw M3x0.50 x 6) | BOM Mass | Stainless Steel | 0.11 | 0.0008 | FOUND | ⚠️ Fuzzy matched to BOM entry 'Hex socket head cap screw M3x0.50 x 6' |
| right_arm_1_l4_ASM_2_Hex_socket_head_cap_screw_M3x050_x_6 | (fuzzy: Hex socket head cap screw M3x0.50 x 6) | BOM Mass | Stainless Steel | 0.11 | 0.0008 | FOUND | ⚠️ Fuzzy matched to BOM entry 'Hex socket head cap screw M3x0.50 x 6' |
| right_arm_1_l4_ASM_2_Hex_socket_head_cap_screw_M3x050_x_6 | (fuzzy: Hex socket head cap screw M3x0.50 x 6) | BOM Mass | Stainless Steel | 0.11 | 0.0008 | FOUND | ⚠️ Fuzzy matched to BOM entry 'Hex socket head cap screw M3x0.50 x 6' |
| right_arm_1_l4_ASM_2_J4_D | (fuzzy: J4_D) | BOM Mass | Stainless Steel 304 | 9.67 | 0.0777 | FOUND | ⚠️ Fuzzy matched to BOM entry 'J4_D' |
| right_arm_1_l4_ASM_2_Hex_socket_head_cap_screw_M3x050_x_8 | (fuzzy: Hex socket head cap screw M3x0.50 x 8) | BOM Mass | Stainless Steel | 0.12 | 0.0009 | FOUND | ⚠️ Fuzzy matched to BOM entry 'Hex socket head cap screw M3x0.50 x 8' |
| right_arm_1_l4_ASM_2_Hex_socket_head_cap_screw_M3x050_x_8 | (fuzzy: Hex socket head cap screw M3x0.50 x 8) | BOM Mass | Stainless Steel | 0.12 | 0.0009 | FOUND | ⚠️ Fuzzy matched to BOM entry 'Hex socket head cap screw M3x0.50 x 8' |
| right_arm_1_l4_ASM_2_Hex_socket_head_cap_screw_M3x050_x_6 | (fuzzy: Hex socket head cap screw M3x0.50 x 6) | BOM Mass | Stainless Steel | 0.11 | 0.0008 | FOUND | ⚠️ Fuzzy matched to BOM entry 'Hex socket head cap screw M3x0.50 x 6' |
| right_arm_1_l4_ASM_2_Hex_socket_head_cap_screw_M3x050_x_6 | (fuzzy: Hex socket head cap screw M3x0.50 x 6) | BOM Mass | Stainless Steel | 0.11 | 0.0008 | FOUND | ⚠️ Fuzzy matched to BOM entry 'Hex socket head cap screw M3x0.50 x 6' |
| right_arm_1_l4_ASM_2_Hex_socket_head_cap_screw_M3x050_x_6 | (fuzzy: Hex socket head cap screw M3x0.50 x 6) | BOM Mass | Stainless Steel | 0.11 | 0.0008 | FOUND | ⚠️ Fuzzy matched to BOM entry 'Hex socket head cap screw M3x0.50 x 6' |

**Link Total:** 0.5166 kg
**Warnings:** 28 parts with issues

---

## Link: right_arm_l5

| Part | BOM Match | Mass Source | Material | Volume (cm³) | Mass (kg) | Mesh Match | Status |
|---|---|---|---|---|---|---|---|
| right_arm_1_l5_right_ASM_1_J5_A | (fuzzy: J5_A) | BOM Mass | ppa-cf | 12.65 | 0.0158 | FOUND | ⚠️ Fuzzy matched to BOM entry 'J5_A' |
| right_arm_1_l5_right_ASM_1_J6_B | (fuzzy: J6_B) | BOM Mass | Stainless Steel 304 | 5.37 | 0.0431 | FOUND | ⚠️ Fuzzy matched to BOM entry 'J6_B' |
| right_arm_1_l5_right_ASM_1_J6_A | (fuzzy: J6_A) | BOM Mass | Stainless Steel 304 | 6.73 | 0.0540 | FOUND | ⚠️ Fuzzy matched to BOM entry 'J6_A' |
| right_arm_1_l5_right_ASM_1_Hex_socket_head_cap_screw_M3x050_x_18 | (fuzzy: Hex socket head cap screw M3x0.50 x 18) | BOM Mass | Stainless Steel | 0.19 | 0.0015 | FOUND | ⚠️ Fuzzy matched to BOM entry 'Hex socket head cap screw M3x0.50 x 18' |
| right_arm_1_l5_right_ASM_1_Hex_socket_head_cap_screw_M3x050_x_18 | (fuzzy: Hex socket head cap screw M3x0.50 x 18) | BOM Mass | Stainless Steel | 0.19 | 0.0015 | FOUND | ⚠️ Fuzzy matched to BOM entry 'Hex socket head cap screw M3x0.50 x 18' |
| right_arm_1_l5_right_ASM_1_Hex_socket_head_cap_screw_M3x050_x_18 | (fuzzy: Hex socket head cap screw M3x0.50 x 18) | BOM Mass | Stainless Steel | 0.19 | 0.0015 | FOUND | ⚠️ Fuzzy matched to BOM entry 'Hex socket head cap screw M3x0.50 x 18' |
| right_arm_1_l5_right_ASM_1_Hex_socket_head_cap_screw_M3x050_x_18 | (fuzzy: Hex socket head cap screw M3x0.50 x 18) | BOM Mass | Stainless Steel | 0.19 | 0.0015 | FOUND | ⚠️ Fuzzy matched to BOM entry 'Hex socket head cap screw M3x0.50 x 18' |
| right_arm_1_l5_right_ASM_1_Hex_socket_head_cap_screw_M3x050_x_18 | (fuzzy: Hex socket head cap screw M3x0.50 x 18) | BOM Mass | Stainless Steel | 0.19 | 0.0015 | FOUND | ⚠️ Fuzzy matched to BOM entry 'Hex socket head cap screw M3x0.50 x 18' |
| right_arm_1_l5_right_ASM_1_Hex_socket_head_cap_screw_M3x050_x_18 | (fuzzy: Hex socket head cap screw M3x0.50 x 18) | BOM Mass | Stainless Steel | 0.19 | 0.0015 | FOUND | ⚠️ Fuzzy matched to BOM entry 'Hex socket head cap screw M3x0.50 x 18' |
| right_arm_1_l5_right_ASM_1_Hex_socket_head_cap_screw_M3x050_x_8 | (fuzzy: Hex socket head cap screw M3x0.50 x 8) | BOM Mass | Stainless Steel | 0.12 | 0.0009 | FOUND | ⚠️ Fuzzy matched to BOM entry 'Hex socket head cap screw M3x0.50 x 8' |
| right_arm_1_l5_right_ASM_1_Hex_socket_head_cap_screw_M3x050_x_8 | (fuzzy: Hex socket head cap screw M3x0.50 x 8) | BOM Mass | Stainless Steel | 0.12 | 0.0009 | FOUND | ⚠️ Fuzzy matched to BOM entry 'Hex socket head cap screw M3x0.50 x 8' |
| right_arm_1_l5_right_ASM_1_Hex_socket_head_cap_screw_M3x050_x_8 | (fuzzy: Hex socket head cap screw M3x0.50 x 8) | BOM Mass | Stainless Steel | 0.12 | 0.0009 | FOUND | ⚠️ Fuzzy matched to BOM entry 'Hex socket head cap screw M3x0.50 x 8' |
| right_arm_1_l5_right_ASM_1_C-FL6700ZZ | (fuzzy: C-FL6700ZZ) | BOM Mass | - | 0.41 | 0.0000 | FOUND | ⚠️ Fuzzy matched to BOM entry 'C-FL6700ZZ' |
| right_arm_1_l5_right_ASM_1_Hex_socket_head_cap_screw_M3x050_x_6 | (fuzzy: Hex socket head cap screw M3x0.50 x 6) | BOM Mass | Stainless Steel | 0.11 | 0.0008 | FOUND | ⚠️ Fuzzy matched to BOM entry 'Hex socket head cap screw M3x0.50 x 6' |
| right_arm_1_l5_right_ASM_1_Hex_socket_head_cap_screw_M3x050_x_6 | (fuzzy: Hex socket head cap screw M3x0.50 x 6) | BOM Mass | Stainless Steel | 0.11 | 0.0008 | FOUND | ⚠️ Fuzzy matched to BOM entry 'Hex socket head cap screw M3x0.50 x 6' |
| right_arm_1_l5_right_ASM_1_4310 | (fuzzy: 4310) | BOM Mass | - | 109.88 | 0.3000 | FOUND | ⚠️ Fuzzy matched to BOM entry '4310' |
| right_arm_1_l5_right_ASM_1_Hex_socket_head_cap_screw_M3x050_x_8 | (fuzzy: Hex socket head cap screw M3x0.50 x 8) | BOM Mass | Stainless Steel | 0.12 | 0.0009 | FOUND | ⚠️ Fuzzy matched to BOM entry 'Hex socket head cap screw M3x0.50 x 8' |
| right_arm_1_l5_right_ASM_1_Hex_socket_head_cap_screw_M3x050_x_8 | (fuzzy: Hex socket head cap screw M3x0.50 x 8) | BOM Mass | Stainless Steel | 0.12 | 0.0009 | FOUND | ⚠️ Fuzzy matched to BOM entry 'Hex socket head cap screw M3x0.50 x 8' |
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
| right_arm_1_l5_right_ASM_1_Hex_socket_head_cap_screw_M3x050_x_6 | (fuzzy: Hex socket head cap screw M3x0.50 x 6) | BOM Mass | Stainless Steel | 0.11 | 0.0008 | FOUND | ⚠️ Fuzzy matched to BOM entry 'Hex socket head cap screw M3x0.50 x 6' |
| right_arm_1_l5_right_ASM_1_Hex_socket_head_cap_screw_M3x050_x_6 | (fuzzy: Hex socket head cap screw M3x0.50 x 6) | BOM Mass | Stainless Steel | 0.11 | 0.0008 | FOUND | ⚠️ Fuzzy matched to BOM entry 'Hex socket head cap screw M3x0.50 x 6' |

**Link Total:** 0.4821 kg
**Warnings:** 38 parts with issues

---

## Link: right_arm_l6

| Part | BOM Match | Mass Source | Material | Volume (cm³) | Mass (kg) | Mesh Match | Status |
|---|---|---|---|---|---|---|---|
| right_arm_1_l6_URDF_1_J7_AB | (fuzzy: J7_AB) | BOM Mass | PETG | 29.36 | 0.0382 | FOUND | ⚠️ Fuzzy matched to BOM entry 'J7_AB' |
| right_arm_1_l6_URDF_1_4310 | (fuzzy: 4310) | BOM Mass | - | 109.88 | 0.3000 | FOUND | ⚠️ Fuzzy matched to BOM entry '4310' |
| right_arm_1_l6_URDF_1_Hex_socket_head_cap_screw_M3x050_x_8 | (fuzzy: Hex socket head cap screw M3x0.50 x 8) | BOM Mass | Stainless Steel | 0.12 | 0.0009 | FOUND | ⚠️ Fuzzy matched to BOM entry 'Hex socket head cap screw M3x0.50 x 8' |
| right_arm_1_l6_URDF_1_Hex_socket_head_cap_screw_M3x050_x_8 | (fuzzy: Hex socket head cap screw M3x0.50 x 8) | BOM Mass | Stainless Steel | 0.12 | 0.0009 | FOUND | ⚠️ Fuzzy matched to BOM entry 'Hex socket head cap screw M3x0.50 x 8' |
| right_arm_1_l6_URDF_1_Hex_socket_head_cap_screw_M3x050_x_8 | (fuzzy: Hex socket head cap screw M3x0.50 x 8) | BOM Mass | Stainless Steel | 0.12 | 0.0009 | FOUND | ⚠️ Fuzzy matched to BOM entry 'Hex socket head cap screw M3x0.50 x 8' |
| right_arm_1_l6_URDF_1_J7_C | (fuzzy: J7_C) | BOM Mass | Aluminum - 6061 | 3.20 | 0.0087 | FOUND | ⚠️ Fuzzy matched to BOM entry 'J7_C' |
| right_arm_1_l6_URDF_1_Hex_socket_head_cap_screw_M3x050_x_8 | (fuzzy: Hex socket head cap screw M3x0.50 x 8) | BOM Mass | Stainless Steel | 0.12 | 0.0009 | FOUND | ⚠️ Fuzzy matched to BOM entry 'Hex socket head cap screw M3x0.50 x 8' |
| right_arm_1_l6_URDF_1_Hex_socket_head_cap_screw_M3x050_x_8 | (fuzzy: Hex socket head cap screw M3x0.50 x 8) | BOM Mass | Stainless Steel | 0.12 | 0.0009 | FOUND | ⚠️ Fuzzy matched to BOM entry 'Hex socket head cap screw M3x0.50 x 8' |

**Link Total:** 0.3515 kg
**Warnings:** 8 parts with issues

---

## Link: right_arm_l7

| Part | BOM Match | Mass Source | Material | Volume (cm³) | Mass (kg) | Mesh Match | Status |
|---|---|---|---|---|---|---|---|
| right_arm_1_J8_A | (fuzzy: J8_A) | BOM Mass | Aluminum - 6061 | 13.49 | 0.0367 | FOUND | ⚠️ Fuzzy matched to BOM entry 'J8_A' |
| right_arm_1_gripper_1_J8_B | (fuzzy: J8_B) | BOM Mass | ppa-cf | 19.97 | 0.0218 | FOUND | ⚠️ Fuzzy matched to BOM entry 'J8_B' |
| right_arm_1_gripper_1_4310 | (fuzzy: 4310) | BOM Mass | - | 109.88 | 0.3000 | FOUND | ⚠️ Fuzzy matched to BOM entry '4310' |
| right_arm_1_gripper_1_J8_B | (fuzzy: J8_B) | BOM Mass | ppa-cf | 19.97 | 0.0218 | FOUND | ⚠️ Fuzzy matched to BOM entry 'J8_B' |
| right_arm_1_gripper_1_rail_connector | - | Default Density | - | 8.46 | 0.0085 | FOUND | ⚠️ Not found in BOM |
| right_arm_1_gripper_1_swivel_rotor | - | Default Density | - | 11.95 | 0.0120 | FOUND | ⚠️ Not found in BOM |
| right_arm_1_gripper_1_J8_A | (fuzzy: J8_A) | BOM Mass | Aluminum - 6061 | 13.49 | 0.0367 | FOUND | ⚠️ Fuzzy matched to BOM entry 'J8_A' |
| right_arm_1_gripper_1_rse2b10-155_rail_v3 | - | Default Density | - | 6.22 | 0.0062 | FOUND | ⚠️ Not found in BOM |
| right_arm_1_gripper_1_swivel_link | - | Default Density | - | 1.39 | 0.0014 | FOUND | ⚠️ Not found in BOM |
| right_arm_1_gripper_1_swivel_link | - | Default Density | - | 1.39 | 0.0014 | FOUND | ⚠️ Not found in BOM |
| right_arm_1_gripper_1_rse2b10-155_block_v3 | - | Default Density | - | 3.52 | 0.0035 | FOUND | ⚠️ Not found in BOM |
| right_arm_1_gripper_1_rse2b10-155_block_v3 | - | Default Density | - | 3.52 | 0.0035 | FOUND | ⚠️ Not found in BOM |
| right_arm_1_gripper_1_rail_CNC_attachment | - | Default Density | - | 6.25 | 0.0063 | FOUND | ⚠️ Not found in BOM |
| right_arm_1_gripper_1_rail_CNC_attachment | - | Default Density | - | 6.25 | 0.0063 | FOUND | ⚠️ Not found in BOM |
| right_arm_1_gripper_1_left_jaw | - | Default Density | - | 27.86 | 0.0279 | FOUND | ⚠️ Not found in BOM |
| right_arm_1_gripper_1_right_jaw | - | Default Density | - | 27.86 | 0.0279 | FOUND | ⚠️ Not found in BOM |

**Link Total:** 0.5217 kg
**Warnings:** 16 parts with issues

---

## Link: torso_link

| Part | BOM Match | Mass Source | Material | Volume (cm³) | Mass (kg) | Mesh Match | Status |
|---|---|---|---|---|---|---|---|
| assemble_urdf_1_sub-asm-vert_1_J_waist_pitch_C_CNC | (fuzzy: J_waist_pitch_C_CNC) | BOM Mass | Aluminum - 6061 | 69.76 | 0.1898 | FOUND | ⚠️ Fuzzy matched to BOM entry 'J_waist_pitch_C_CNC' |
| Hex_socket_head_cap_screw_M6x100_x_12 | Hex socket head cap screw M6x1.00 x 12 | BOM Mass | Stainless Steel | 0.74 | 0.0057 | FOUND | ✓ |
| Hex_socket_head_cap_screw_M6x100_x_12 | Hex socket head cap screw M6x1.00 x 12 | BOM Mass | Stainless Steel | 0.74 | 0.0057 | FOUND | ✓ |
| Hex_socket_head_cap_screw_M6x100_x_12 | Hex socket head cap screw M6x1.00 x 12 | BOM Mass | Stainless Steel | 0.74 | 0.0057 | FOUND | ✓ |
| Hex_socket_head_cap_screw_M6x100_x_12 | Hex socket head cap screw M6x1.00 x 12 | BOM Mass | Stainless Steel | 0.74 | 0.0057 | FOUND | ✓ |
| assemble_urdf_1_sub-asm-vert_1_J_waist_pitch_D_for_CNC | (fuzzy: J_waist_pitch_D_for_CNC) | BOM Mass | Stainless Steel 304 | 6.91 | 0.0555 | FOUND | ⚠️ Fuzzy matched to BOM entry 'J_waist_pitch_D_for_CNC' |
| assemble_urdf_1_sub-asm-vert_1_Hex_socket_head_cap_screw_M3x050_x_10 | (fuzzy: Hex socket head cap screw M3x0.50 x 10) | BOM Mass | Stainless Steel | 0.13 | 0.0010 | FOUND | ⚠️ Fuzzy matched to BOM entry 'Hex socket head cap screw M3x0.50 x 10' |
| assemble_urdf_1_sub-asm-vert_1_Hex_socket_head_cap_screw_M3x050_x_10 | (fuzzy: Hex socket head cap screw M3x0.50 x 10) | BOM Mass | Stainless Steel | 0.13 | 0.0010 | FOUND | ⚠️ Fuzzy matched to BOM entry 'Hex socket head cap screw M3x0.50 x 10' |
| extrusion | extrusion | BOM Mass | Aluminum - 6061 | 366.62 | 0.9972 | FOUND | ✓ |
| assemble_urdf_1_sub-asm-vert_1_J_waist_pitch_AB_CNC | (fuzzy: J_waist_pitch_AB_CNC) | BOM Mass | Aluminum - 6061 | 69.94 | 0.1902 | FOUND | ⚠️ Fuzzy matched to BOM entry 'J_waist_pitch_AB_CNC' |
| left_arm_1_base_left_ASM_1_J1_A | (fuzzy: J1_A) | BOM Mass | ppa-cf | 51.63 | 0.0645 | FOUND | ⚠️ Fuzzy matched to BOM entry 'J1_A' |
| right_arm_1_base_ASM_1_J1_A | (fuzzy: J1_A) | BOM Mass | ppa-cf | 51.63 | 0.0645 | FOUND | ⚠️ Fuzzy matched to BOM entry 'J1_A' |
| Hex_socket_head_cap_screw_M6x100_x_12 | Hex socket head cap screw M6x1.00 x 12 | BOM Mass | Stainless Steel | 0.74 | 0.0057 | FOUND | ✓ |
| Hex_socket_head_cap_screw_M6x100_x_12 | Hex socket head cap screw M6x1.00 x 12 | BOM Mass | Stainless Steel | 0.74 | 0.0057 | FOUND | ✓ |
| Hex_socket_head_cap_screw_M6x100_x_12 | Hex socket head cap screw M6x1.00 x 12 | BOM Mass | Stainless Steel | 0.74 | 0.0057 | FOUND | ✓ |
| Hex_socket_head_cap_screw_M6x100_x_12 | Hex socket head cap screw M6x1.00 x 12 | BOM Mass | Stainless Steel | 0.74 | 0.0057 | FOUND | ✓ |
| assemble_urdf_1_sub-asm-vert_1_Hex_socket_head_cap_screw_M5x080_x_18 | (fuzzy: Hex socket head cap screw M5x0.80 x 18) | BOM Mass | Steel | 0.60 | 0.0047 | FOUND | ⚠️ Fuzzy matched to BOM entry 'Hex socket head cap screw M5x0.80 x 18' |
| assemble_urdf_1_sub-asm-vert_1_Hex_socket_head_cap_screw_M5x080_x_18 | (fuzzy: Hex socket head cap screw M5x0.80 x 18) | BOM Mass | Steel | 0.60 | 0.0047 | FOUND | ⚠️ Fuzzy matched to BOM entry 'Hex socket head cap screw M5x0.80 x 18' |
| assemble_urdf_1_sub-asm-vert_1_Hex_socket_head_cap_screw_M5x080_x_18 | (fuzzy: Hex socket head cap screw M5x0.80 x 18) | BOM Mass | Steel | 0.60 | 0.0047 | FOUND | ⚠️ Fuzzy matched to BOM entry 'Hex socket head cap screw M5x0.80 x 18' |
| assemble_urdf_1_sub-asm-vert_1_Hex_socket_head_cap_screw_M5x080_x_18 | (fuzzy: Hex socket head cap screw M5x0.80 x 18) | BOM Mass | Steel | 0.60 | 0.0047 | FOUND | ⚠️ Fuzzy matched to BOM entry 'Hex socket head cap screw M5x0.80 x 18' |
| assemble_urdf_1_sub-asm-vert_1_Hex_socket_head_cap_screw_M5x080_x_18 | (fuzzy: Hex socket head cap screw M5x0.80 x 18) | BOM Mass | Steel | 0.60 | 0.0047 | FOUND | ⚠️ Fuzzy matched to BOM entry 'Hex socket head cap screw M5x0.80 x 18' |
| assemble_urdf_1_sub-asm-vert_1_Hex_socket_head_cap_screw_M5x080_x_18 | (fuzzy: Hex socket head cap screw M5x0.80 x 18) | BOM Mass | Steel | 0.60 | 0.0047 | FOUND | ⚠️ Fuzzy matched to BOM entry 'Hex socket head cap screw M5x0.80 x 18' |
| assemble_urdf_1_sub-asm-vert_1_Hex_socket_head_cap_screw_M5x080_x_18 | (fuzzy: Hex socket head cap screw M5x0.80 x 18) | BOM Mass | Steel | 0.60 | 0.0047 | FOUND | ⚠️ Fuzzy matched to BOM entry 'Hex socket head cap screw M5x0.80 x 18' |
| assemble_urdf_1_sub-asm-vert_1_Hex_socket_head_cap_screw_M5x080_x_18 | (fuzzy: Hex socket head cap screw M5x0.80 x 18) | BOM Mass | Steel | 0.60 | 0.0047 | FOUND | ⚠️ Fuzzy matched to BOM entry 'Hex socket head cap screw M5x0.80 x 18' |
| assemble_urdf_1_sub-asm-vert_1_Hex_socket_head_cap_screw_M5x080_x_18 | (fuzzy: Hex socket head cap screw M5x0.80 x 18) | BOM Mass | Steel | 0.60 | 0.0047 | FOUND | ⚠️ Fuzzy matched to BOM entry 'Hex socket head cap screw M5x0.80 x 18' |
| assemble_urdf_1_sub-asm-vert_1_Hex_socket_head_cap_screw_M3x050_x_10 | (fuzzy: Hex socket head cap screw M3x0.50 x 10) | BOM Mass | Stainless Steel | 0.13 | 0.0010 | FOUND | ⚠️ Fuzzy matched to BOM entry 'Hex socket head cap screw M3x0.50 x 10' |
| assemble_urdf_1_sub-asm-vert_1_Hex_socket_head_cap_screw_M3x050_x_10 | (fuzzy: Hex socket head cap screw M3x0.50 x 10) | BOM Mass | Stainless Steel | 0.13 | 0.0010 | FOUND | ⚠️ Fuzzy matched to BOM entry 'Hex socket head cap screw M3x0.50 x 10' |
| left_arm_1_base_left_ASM_1_DM-J8009P-2EC | (fuzzy: DM-J8009P-2EC) | BOM Mass | - | 387.45 | 0.9210 | FOUND | ⚠️ Fuzzy matched to BOM entry 'DM-J8009P-2EC' |
| left_arm_1_base_left_ASM_1_Hex_socket_head_cap_screw_M4x070_x_10 | (fuzzy: Hex socket head cap screw M4x0.70 x 10) | BOM Mass | Stainless Steel | 0.26 | 0.0020 | FOUND | ⚠️ Fuzzy matched to BOM entry 'Hex socket head cap screw M4x0.70 x 10' |
| left_arm_1_base_left_ASM_1_Hex_socket_head_cap_screw_M4x070_x_10 | (fuzzy: Hex socket head cap screw M4x0.70 x 10) | BOM Mass | Stainless Steel | 0.26 | 0.0020 | FOUND | ⚠️ Fuzzy matched to BOM entry 'Hex socket head cap screw M4x0.70 x 10' |
| left_arm_1_base_left_ASM_1_Hex_socket_head_cap_screw_M4x070_x_10 | (fuzzy: Hex socket head cap screw M4x0.70 x 10) | BOM Mass | Stainless Steel | 0.26 | 0.0020 | FOUND | ⚠️ Fuzzy matched to BOM entry 'Hex socket head cap screw M4x0.70 x 10' |
| left_arm_1_base_left_ASM_1_Hex_socket_head_cap_screw_M4x070_x_10 | (fuzzy: Hex socket head cap screw M4x0.70 x 10) | BOM Mass | Stainless Steel | 0.26 | 0.0020 | FOUND | ⚠️ Fuzzy matched to BOM entry 'Hex socket head cap screw M4x0.70 x 10' |
| left_arm_1_base_left_ASM_1_Hex_socket_head_cap_screw_M4x070_x_10 | (fuzzy: Hex socket head cap screw M4x0.70 x 10) | BOM Mass | Stainless Steel | 0.26 | 0.0020 | FOUND | ⚠️ Fuzzy matched to BOM entry 'Hex socket head cap screw M4x0.70 x 10' |
| left_arm_1_base_left_ASM_1_Hex_socket_head_cap_screw_M6x100_x_12 | (fuzzy: Hex socket head cap screw M6x1.00 x 12) | BOM Mass | Stainless Steel | 0.74 | 0.0057 | FOUND | ⚠️ Fuzzy matched to BOM entry 'Hex socket head cap screw M6x1.00 x 12' |
| left_arm_1_base_left_ASM_1_Hex_socket_head_cap_screw_M6x100_x_12 | (fuzzy: Hex socket head cap screw M6x1.00 x 12) | BOM Mass | Stainless Steel | 0.74 | 0.0057 | FOUND | ⚠️ Fuzzy matched to BOM entry 'Hex socket head cap screw M6x1.00 x 12' |
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
| right_arm_1_base_ASM_1_Hex_socket_head_cap_screw_M4x070_x_8 | (fuzzy: Hex socket head cap screw M4x0.70 x 8) | BOM Mass | Stainless Steel | 0.24 | 0.0018 | FOUND | ⚠️ Fuzzy matched to BOM entry 'Hex socket head cap screw M4x0.70 x 8' |
| right_arm_1_base_ASM_1_Hex_socket_head_cap_screw_M4x070_x_8 | (fuzzy: Hex socket head cap screw M4x0.70 x 8) | BOM Mass | Stainless Steel | 0.24 | 0.0018 | FOUND | ⚠️ Fuzzy matched to BOM entry 'Hex socket head cap screw M4x0.70 x 8' |

**Link Total:** 3.6040 kg
**Warnings:** 46 parts with issues

---

## Link: waist_link

| Part | BOM Match | Mass Source | Material | Volume (cm³) | Mass (kg) | Mesh Match | Status |
|---|---|---|---|---|---|---|---|
| assemble_urdf_1_sub-asm-vert_1_J_waist_yaw_A_CNC | (fuzzy: J_waist_yaw_A_CNC) | BOM Mass | Aluminum - 6061 | 26.11 | 0.0710 | FOUND | ⚠️ Fuzzy matched to BOM entry 'J_waist_yaw_A_CNC' |
| assemble_urdf_1_Hex_socket_head_cap_screw_M5x080_x_10 | (fuzzy: Hex socket head cap screw M5x0.80 x 10) | BOM Mass | Stainless Steel | 0.44 | 0.0034 | FOUND | ⚠️ Fuzzy matched to BOM entry 'Hex socket head cap screw M5x0.80 x 10' |
| assemble_urdf_1_Hex_socket_head_cap_screw_M5x080_x_10 | (fuzzy: Hex socket head cap screw M5x0.80 x 10) | BOM Mass | Stainless Steel | 0.44 | 0.0034 | FOUND | ⚠️ Fuzzy matched to BOM entry 'Hex socket head cap screw M5x0.80 x 10' |
| assemble_urdf_1_Hex_socket_head_cap_screw_M5x080_x_10 | (fuzzy: Hex socket head cap screw M5x0.80 x 10) | BOM Mass | Stainless Steel | 0.44 | 0.0034 | FOUND | ⚠️ Fuzzy matched to BOM entry 'Hex socket head cap screw M5x0.80 x 10' |
| assemble_urdf_1_Hex_socket_head_cap_screw_M5x080_x_10 | (fuzzy: Hex socket head cap screw M5x0.80 x 10) | BOM Mass | Stainless Steel | 0.44 | 0.0034 | FOUND | ⚠️ Fuzzy matched to BOM entry 'Hex socket head cap screw M5x0.80 x 10' |
| assemble_urdf_1_Hex_socket_head_cap_screw_M5x080_x_10 | (fuzzy: Hex socket head cap screw M5x0.80 x 10) | BOM Mass | Stainless Steel | 0.44 | 0.0034 | FOUND | ⚠️ Fuzzy matched to BOM entry 'Hex socket head cap screw M5x0.80 x 10' |
| assemble_urdf_1_Hex_socket_head_cap_screw_M5x080_x_10 | (fuzzy: Hex socket head cap screw M5x0.80 x 10) | BOM Mass | Stainless Steel | 0.44 | 0.0034 | FOUND | ⚠️ Fuzzy matched to BOM entry 'Hex socket head cap screw M5x0.80 x 10' |
| assemble_urdf_1_sub-asm-vert_1_J_waist_yaw_A_CNC_A | (fuzzy: J_waist_yaw_A_CNC_A) | BOM Mass | Stainless Steel 304 | 27.23 | 0.2187 | FOUND | ⚠️ Fuzzy matched to BOM entry 'J_waist_yaw_A_CNC_A' |
| assemble_urdf_1_sub-asm-vert_1_J_waist_yaw_A_CNC_B | (fuzzy: J_waist_yaw_A_CNC_B) | BOM Mass | Stainless Steel 304 | 23.65 | 0.1899 | FOUND | ⚠️ Fuzzy matched to BOM entry 'J_waist_yaw_A_CNC_B' |
| assemble_urdf_1_sub-asm-vert_1_DM-10010L | (fuzzy: DM-10010L) | BOM Mass | - | 443.70 | 1.3720 | FOUND | ⚠️ Fuzzy matched to BOM entry 'DM-10010L' |
| assemble_urdf_1_sub-asm-vert_1_Hex_socket_head_cap_screw_M4x070_x_12 | (fuzzy: Hex socket head cap screw M4x0.70 x 12) | BOM Mass | Steel | 0.29 | 0.0023 | FOUND | ⚠️ Fuzzy matched to BOM entry 'Hex socket head cap screw M4x0.70 x 12' |
| assemble_urdf_1_sub-asm-vert_1_Hex_socket_head_cap_screw_M4x070_x_12 | (fuzzy: Hex socket head cap screw M4x0.70 x 12) | BOM Mass | Steel | 0.29 | 0.0023 | FOUND | ⚠️ Fuzzy matched to BOM entry 'Hex socket head cap screw M4x0.70 x 12' |
| assemble_urdf_1_sub-asm-vert_1_Hex_socket_head_cap_screw_M4x070_x_12 | (fuzzy: Hex socket head cap screw M4x0.70 x 12) | BOM Mass | Steel | 0.29 | 0.0023 | FOUND | ⚠️ Fuzzy matched to BOM entry 'Hex socket head cap screw M4x0.70 x 12' |
| assemble_urdf_1_sub-asm-vert_1_Hex_socket_head_cap_screw_M4x070_x_12 | (fuzzy: Hex socket head cap screw M4x0.70 x 12) | BOM Mass | Steel | 0.29 | 0.0023 | FOUND | ⚠️ Fuzzy matched to BOM entry 'Hex socket head cap screw M4x0.70 x 12' |
| assemble_urdf_1_sub-asm-vert_1_Hex_socket_head_cap_screw_M4x070_x_12 | (fuzzy: Hex socket head cap screw M4x0.70 x 12) | BOM Mass | Steel | 0.29 | 0.0023 | FOUND | ⚠️ Fuzzy matched to BOM entry 'Hex socket head cap screw M4x0.70 x 12' |
| assemble_urdf_1_sub-asm-vert_1_Hex_socket_head_cap_screw_M4x070_x_12 | (fuzzy: Hex socket head cap screw M4x0.70 x 12) | BOM Mass | Steel | 0.29 | 0.0023 | FOUND | ⚠️ Fuzzy matched to BOM entry 'Hex socket head cap screw M4x0.70 x 12' |
| assemble_urdf_1_sub-asm-vert_1_Hex_socket_head_cap_screw_M4x070_x_12 | (fuzzy: Hex socket head cap screw M4x0.70 x 12) | BOM Mass | Steel | 0.29 | 0.0023 | FOUND | ⚠️ Fuzzy matched to BOM entry 'Hex socket head cap screw M4x0.70 x 12' |
| assemble_urdf_1_sub-asm-vert_1_Hex_socket_head_cap_screw_M4x070_x_12 | (fuzzy: Hex socket head cap screw M4x0.70 x 12) | BOM Mass | Steel | 0.29 | 0.0023 | FOUND | ⚠️ Fuzzy matched to BOM entry 'Hex socket head cap screw M4x0.70 x 12' |
| assemble_urdf_1_sub-asm-vert_1_Hex_socket_head_cap_screw_M4x070_x_12 | (fuzzy: Hex socket head cap screw M4x0.70 x 12) | BOM Mass | Steel | 0.29 | 0.0023 | FOUND | ⚠️ Fuzzy matched to BOM entry 'Hex socket head cap screw M4x0.70 x 12' |
| assemble_urdf_1_sub-asm-vert_1_J_waist_yaw_C | (fuzzy: J_waist_yaw_C) | BOM Mass | Aluminum - 6061 | 56.62 | 0.1536 | FOUND | ⚠️ Fuzzy matched to BOM entry 'J_waist_yaw_C' |
| assemble_urdf_1_sub-asm-vert_1_Hex_socket_head_cap_screw_M4x070_x_12 | (fuzzy: Hex socket head cap screw M4x0.70 x 12) | BOM Mass | Steel | 0.29 | 0.0023 | FOUND | ⚠️ Fuzzy matched to BOM entry 'Hex socket head cap screw M4x0.70 x 12' |
| assemble_urdf_1_sub-asm-vert_1_Hex_socket_head_cap_screw_M4x070_x_12 | (fuzzy: Hex socket head cap screw M4x0.70 x 12) | BOM Mass | Steel | 0.29 | 0.0023 | FOUND | ⚠️ Fuzzy matched to BOM entry 'Hex socket head cap screw M4x0.70 x 12' |
| assemble_urdf_1_sub-asm-vert_1_Hex_socket_head_cap_screw_M4x070_x_12 | (fuzzy: Hex socket head cap screw M4x0.70 x 12) | BOM Mass | Steel | 0.29 | 0.0023 | FOUND | ⚠️ Fuzzy matched to BOM entry 'Hex socket head cap screw M4x0.70 x 12' |
| assemble_urdf_1_sub-asm-vert_1_Hex_socket_head_cap_screw_M4x070_x_18 | - | Default Density | - | 0.36 | 0.0004 | FOUND | ⚠️ Not found in BOM |
| assemble_urdf_1_sub-asm-vert_1_Hex_socket_head_cap_screw_M4x070_x_18 | - | Default Density | - | 0.36 | 0.0004 | FOUND | ⚠️ Not found in BOM |
| assemble_urdf_1_sub-asm-vert_1_Hex_socket_head_cap_screw_M4x070_x_18 | - | Default Density | - | 0.36 | 0.0004 | FOUND | ⚠️ Not found in BOM |
| assemble_urdf_1_sub-asm-vert_1_Hex_socket_head_cap_screw_M4x070_x_18 | - | Default Density | - | 0.36 | 0.0004 | FOUND | ⚠️ Not found in BOM |
| assemble_urdf_1_sub-asm-vert_1_J_waist_yaw_B_3D | (fuzzy: J_waist_yaw_B_3D) | BOM Mass | - | 28.96 | 0.0250 | FOUND | ⚠️ Fuzzy matched to BOM entry 'J_waist_yaw_B_3D' |
| assemble_urdf_1_sub-asm-vert_1_Hex_socket_head_cap_screw_M4x070_x_25 | (fuzzy: Hex socket head cap screw M4x0.70 x 25) | BOM Mass | Steel | 0.45 | 0.0035 | FOUND | ⚠️ Fuzzy matched to BOM entry 'Hex socket head cap screw M4x0.70 x 25' |
| assemble_urdf_1_sub-asm-vert_1_Hex_socket_head_cap_screw_M4x070_x_25 | (fuzzy: Hex socket head cap screw M4x0.70 x 25) | BOM Mass | Steel | 0.45 | 0.0035 | FOUND | ⚠️ Fuzzy matched to BOM entry 'Hex socket head cap screw M4x0.70 x 25' |
| assemble_urdf_1_sub-asm-vert_1_Hex_socket_head_cap_screw_M4x070_x_25 | (fuzzy: Hex socket head cap screw M4x0.70 x 25) | BOM Mass | Steel | 0.45 | 0.0035 | FOUND | ⚠️ Fuzzy matched to BOM entry 'Hex socket head cap screw M4x0.70 x 25' |
| assemble_urdf_1_sub-asm-vert_1_Hex_socket_head_cap_screw_M4x070_x_25 | (fuzzy: Hex socket head cap screw M4x0.70 x 25) | BOM Mass | Steel | 0.45 | 0.0035 | FOUND | ⚠️ Fuzzy matched to BOM entry 'Hex socket head cap screw M4x0.70 x 25' |
| assemble_urdf_1_sub-asm-vert_1_fl6804ZZ | (fuzzy: fl6804ZZ) | BOM Mass | Stainless Steel 304 | 3.67 | 0.0295 | FOUND | ⚠️ Fuzzy matched to BOM entry 'fl6804ZZ' |

**Link Total:** 2.1229 kg
**Warnings:** 33 parts with issues

---
